n0aheuw/Individual-Project---Mouse-Investigation/final_report.pdf

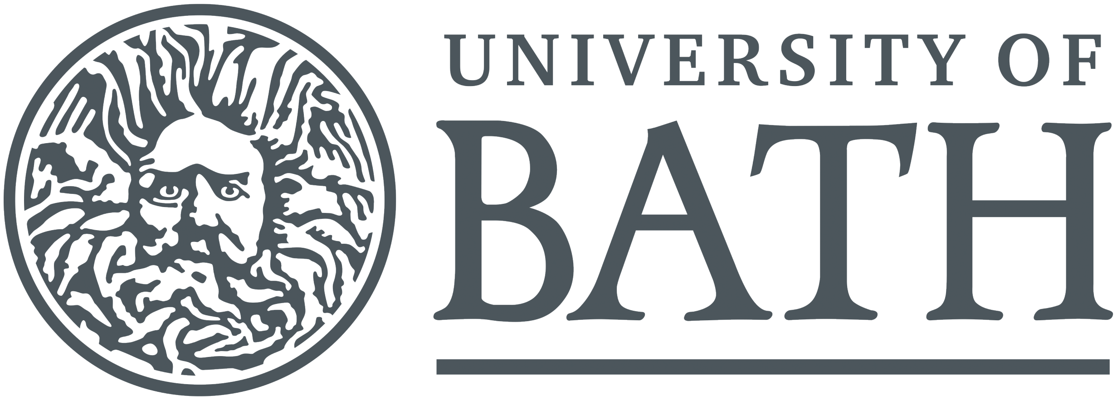
[picture p42: figure]

## Review of Feedback Options for an Accurately Controlled Mouse

## BEng Final Project Report : 2025 (Computer Systems Engineering BEng)

## Noah Johnson

219530358

Wednesday 25th June, 2025

Supervisor: Dr Francis Robinson | Assessor: Dr Stephen Pennock
Main Body Word Count: 8995 | Abstract Word Count: 127

This Project was approved by the Ethics department. Reference: 9890-11232

Abstract

The ‘mouse’ is a second-year group design project. The goal was to investigate ways of improving the ‘mouse’ control loops and reducing its power supply requirements. The aims and objectives were defined as battery reduction, introduction of motor current feedback and wheel speed feedback, accounting for cost, stability and ease of integration. Seven designs were considered; however, only three are recommended as a starting point for future autonomous ‘mouse’ development. The three suggested designs are a simple negative rail generator, low-side current sensing and magnetic speed feedback. All designs were tested and the performance of the three recommended designs was the most satisfactory in terms of accuracy and stability. In addition, the three designs will have a minimal effect on ‘mouse’ cost and are simple to integrate.

## Contents

1 Introduction and Context | 2
2 Position Feedback | 5
3 Speed Feedback | 20
4 Current Feedback | 30

5 Overall Discussion and Conclusions | 42
6 Project Review | 42
7 Acknowledgment | 42
Bibliography | 44
A Appendices | 47

## Figures

1.1 Mouse Track Geometry | | 2
1.2 Mouse Build | | 2
1.3 Original ‘mouse’ System Diagram | | 3
1.4 Updated ‘mouse’ System Block Diagram | | 4
2.1 Simple Voltage Divider | | 5
2.2 Astable 555 Timer Circuit | | 6
2.3 Negative Charge Pump Circuit | | 7
2.4 Precision Diode Clamper Circuit | | 8
2.5 Design A: Schematic | | 9
2.6 Design B: Schematic | 11
2.7 Design A: Oscilloscope Output with input signal of 100mVpp | 13
2.8 Design A: Input Range Response | 14
2.9 Design B: Oscilloscope Output with input signal of 100mVpp | 16
2.10 Design B: Input Range Response | 17
3.1 Hall-Effect Sensor with Pull-up Resitor Schematic | 20
3.2 Diagram of IR emitter and receiver behaviour | 21
3.3 Photographs of ‘mouse’ wheel | 21
3.4 Design D: Schematic | 22
3.5 Design E: Schematic | 24
3.6 Design D: Oscilliscope Rise and Fall | 26
3.7 Design E: Oscilliscope Rise and Fall | 28
4.1 Shunt Resistor Circuit with a motor as circuit load | 30
4.2 Low-side N-channel MOSFET Motor Drive Circuit | 31
4.3 High-side N-channel MOSFET Motor Drive Circuit | 32
4.4 Design F: Schematic | 33
4.5 Design G: Schematic | 35
A.1 RH-32 Breadboard | 51
A.2 34450A KeySight Multi-meter | 52
A.3 DSO1014A Oscilloscope | 52
A.4 AFG2021 Signal Generator | 53
A.5 Lab KeySight E3631A DC Power supply | 53
A.6 AT-6 Tachometer | 54
A.7 Hall-Effect Sensor Distance at Different Angles | 55
A.8 Optical Sensor Distance at Different Angles | 55
A.9 Motor Back EMF Oscilloscope | 57

## Tables

1.1 Sub-Project Letter Assignments | 4
2.1 Design A: Supply and Ground Measurements | 12
2.2 Alphabetically Ordered Estimated Component Costs for Design A | 15
2.3 Design B: Supply and Ground Measurements | 15
2.4 Alphabetically Ordered Estimated Component Costs for Design B | 18
3.1 Design D: RPM Measurements | 25
3.2 Alphabetically Ordered Estimated Component Costs for Design D | 25
3.3 Design E: RPM Measurements | 27
3.4 Alphabetically Ordered Estimated Component Costs for Design E | 27
4.1 Design F: Current Measurements | 37
4.2 Design F: Current Measurements | 37
4.3 Design F: Voltage Measurements 1 kΩ Resistor Load | 38
4.4 Alphabetically Ordered Estimated Component Costs for Design F | 38
4.5 Design G: Current Measurements | 39
4.6 Design G: Current Measurements | 39
4.7 Design G: Voltage Measurements 1 kΩ Resistor Load | 40
4.8 Alphabetically Ordered Estimated Component Costs for Design G | 40
A.1 Total Project Costs | 47
A.2 Estimated Cost of Position Feedback Sub-System | 48
A.3 Estimated Cost of Motor Drive Sub-System | 48
A.4 Hall-Effect Sensor and Tachometer RPM Readings | 57
A.5 Hall-Effect Sensor Working Distance | 57
A.6 Optical Sensor and Tachometer RPM Readings | 57
A.7 Optical Sensor Sensor Working Distance | 57
A.8 Low Side Current and Voltage Measurements | 59
A.9 Low Side Current Measurements with pressure | 59
A.10 Low Side Voltage Measurements with 1 kΩ resistor | 59
A.11 High Side Current and Voltage Measurements | 59
A.12 High Side Current Measurements with pressure | 59
A.13 High Side Voltage Measurements with 1 kΩ resistor | 59

## Acronyms

AC Alternating Current.

ADC Analogue to Digitial Converter.

BJT Bipolar Junction Transistor.

DC Direct Current.

EMF Electro Magnetic Force or Electro Motive Force (Voltage), depending on context.

EMI Electro Magnetic Interference.

GND Ground.

IR Infra Red.

LSB Least Significant Bit.

MOSFET Metal Oxide Semiconductor Field Effect Transistor.

PWM Pulse Width Modulation.

RPM Revolutions Per Minute.

## Definitions

Magnetic Field, H in units of Amps per metre (A/m).

Magnetic Flux, B in units of Tesla (B = µ0).

Permiabilty of a vacuum, µ0 = 4 ∗ π ∗ 10⁻⁷
(H/m).

1

## Introduction and Context

## 1.1 Overview

The autonomous ‘mouse’ is a design project conducted by second-year students at the University of Bath to develop their understanding of control systems and analogue circuit design. The overarching aim of the design project is to complete a lap around a 20 m track (Fig.1.1) in the fastest time possible [1]. The ‘mouse’ project uses differential drive achieved through two motors to navigate around, as seen in Fig.1.2.

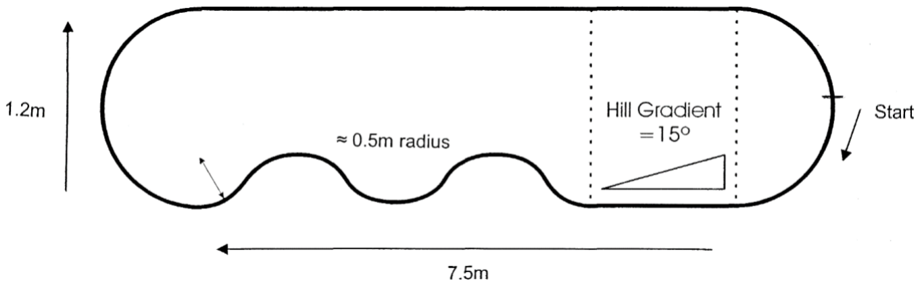
[picture p43: figure]

Figure 1.1: ‘mouse’ test track geometry taken from [1]


Figure 1.2: ‘mouse’ build example taken from [1]

2

The initial concepts used to design the ‘mouse’ in the second year are described in Dr Robinson’s initial document outlining the project [1]. A list of basic ‘mouse’ building blocks can be seen below, and their integration with one another in Fig.1.3.

- LC filter circuit tuned to 20 kHz.
- Signal amplifier circuit.
- Peak detector.
- Arduino microcontroller, takes the input signal and conducts PID control to produce an output drive signal for the motors.
- Motor drive circuit, utilising transistors acting as switches to allow the low-power Arduino to drive the high-power motor load.

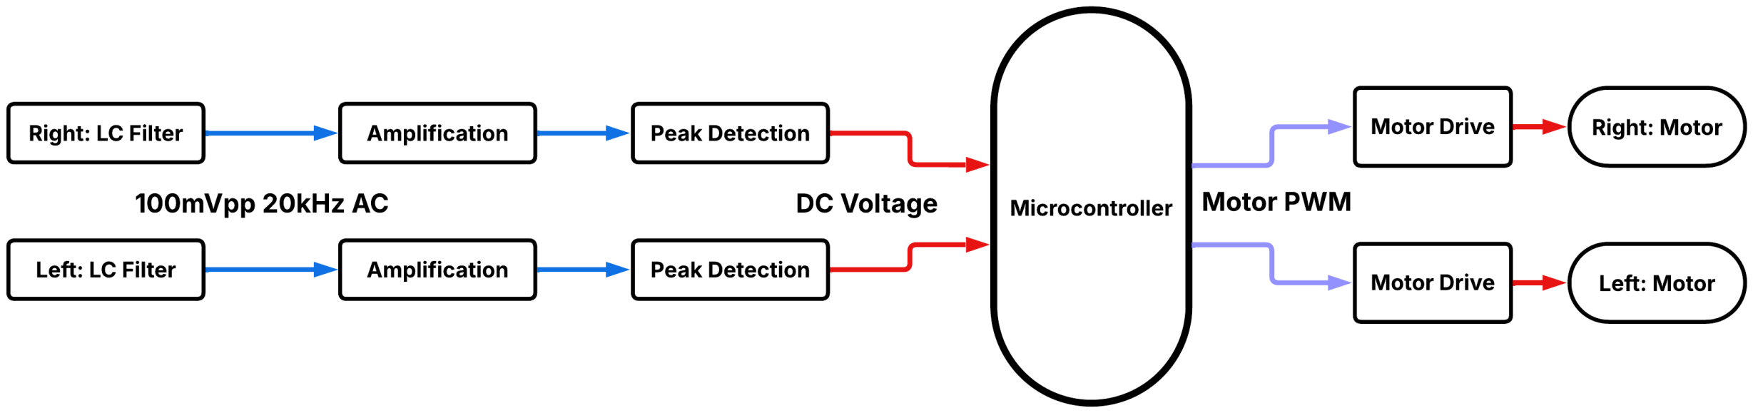
[picture p44: figure]

Figure 1.3: Original ‘mouse’ system diagram: Blue, AC Signals; Red, DC Voltages; Purple, Digital Control Signals

### 1.1.1 Aims and Objectives

As previously outlined in [2], the project has three main aims with varying objectives associated with them:

1. Introduce additional stable and accurate feedback loops to the ‘mouse’ control loop, focusing on the lack of feedback from the motors.
- Motor current.
- Motor speed.
2. Design alterations and suggestions for the ‘mouse’ that are low-cost and straightforward to integrate.
- Designs should be simple to integrate into a ‘mouse’ project and documentation be available in textbooks or data sheets to assist students if the design is harder to implement.
- Component choice to be limited to low-cost components/modules, keeping a low-cost per ‘mouse’. Sub-system changes will ideally keep the cost within +25% of the original cost.
3. Investigate the power supply options for the mouse, identifying methods for reducing power supply requirements.
- The number of battery packs used to power the mouse ideally reduced from 2 x 9 V PP3 alkaline batteries and 4 x 1.2 V NiMH AA batteries.

3

### 1.1.2 Constraints

The constraints of this project follow those set out in [1], with an additional self-imposed constraint of not increasing the sub-system cost by over 25% when compared to current sub-systems.

## 1.2 Initial Ideas Regarding Implementation

- To reduce consumables, weight, and improve environmental impact by removing one of the 9 V alkaline batteries.
- To improve the motor control loop by adding motor current and wheel speed as additional feedback parameters. Potential new system diagram as shown in Fig.1.4.

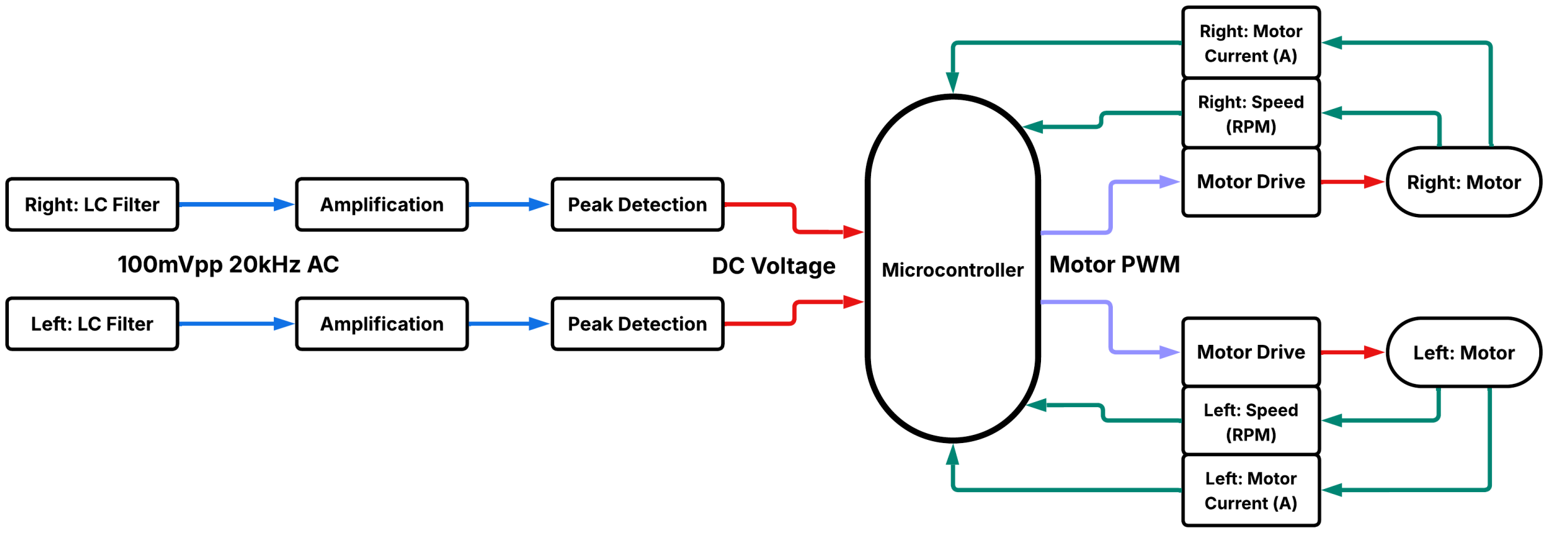
[picture p45: figure]

Figure 1.4: Updated ‘mouse’ system diagram: Blue, AC Signals; Red, DC Voltages; Purple, Digital Control Signals; Teal, Additional Feedback

Table 1.1: Sub-Project Letter Assignments

Design Letter | Sub-Project Name | Sub-system
A | Voltage Divider | Position Feeedback
B | 555 Timer | Position Feeedback
C | Precision Diode Clamper | Position Feeedback
D | Hall Effect Sensor | Speed Feeedback
E | IR Optical Sensor | Speed Feeedback
F | Low Side Motor Drive | Current Feedback
G | High Side Motor Drive | Current Feedback

Table 1.1 lists the sub-projects and the letters assigned for quick reference, including the relevant affected sub-systems.

### 1.2.1 Results Gathering

All testing procedures and methods list the equipment used, photographed in Appendix A.4.

4

## Position Feedback

## 2.1 Overview

This section discusses the position feedback sub-system of the autonomous ‘mouse’. The position feedback within the ‘mouse’ control loop is responsible for detecting the mouse’s approximate location in relation to the track wire and providing a position feedback signal for steering correction. The current circuit design utilises inductive pick-up coils to sense the AC magnetic flux generated by a trackwire conducting at 20 kHz ≃ 1 A. The induced voltage signal is subsequently processed by filtering, amplification and peak detector stages to produce a DC feedback signal [1].
A key focus of this section is to address one of the limitations identified in the original sensing sub-system design: the requirement for a dual power supply to bias the operational amplifier appropriately to process a 100 mVpp AC signal. This dependency increases the number of batteries required, increasing the ‘mouse’ weight and the project’s environmental impact by increasing e-waste. This section aims to explore and implement alternative circuit configurations capable of operating from a single supply of 9 V DC. The proposed solutions must maintain signal integrity and compatibility with downstream control systems. The designs must be evaluated on performance, simplicity, and cost of implementation.

## 2.2 Design Concepts and Methods

### 2.2.1 Design A: Voltage Divider

Design A (Fig.2.1) employs a voltage divider to proportionally split the 9 V input supply voltage to create a new virtual GND. The division is done across two or more resistive sources (see Fig.2.1) with the output voltage dependent on the ratio between the component’s impedances. The resulting output voltage equation (Eq.2.1) is derived using Kirchhoff’s Voltage Law and Ohm’s Law, where Z1 and Z2 are impedances of the two components shown in Fig.2.1. The impedance ratio in Design A is set at 1 : 1 resulting in a 4.5 V virtual GND

VOut =

Z2
Z1 + Z2
∗ Vs | (2.1)

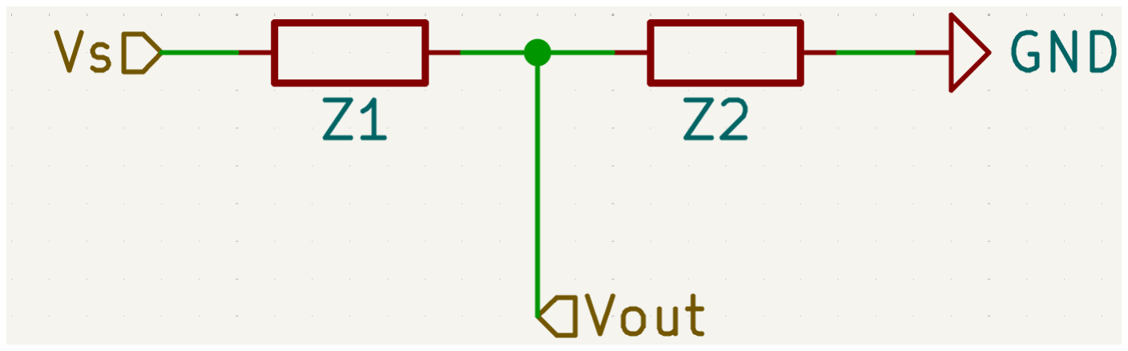
[picture p46: figure]

Figure 2.1: Voltage divider circuit with two resistive components, Vs is the supply voltage and Vout is the reduced voltage reference.

The new 4.5 V virtual GND becomes the new reference point for the operational amplifier and input signal. The operational amplifier and input signal will treat the 4.5 V reference as its

5

GND. Biasing the operational amplifier and input signal this way allows the supply rails to be at 9 V (+ve supply) and 0 V (−ve supply), and allows for the use of a single power supply, however the operational amplifier is now operated with a ±4.5 V supply halving amplification potential. Therefore, an AC-coupled input signal will not reduce the inputs below the −ve supply rail and cause the operational amplifier to malfunction.

### 2.2.2 Design B: 555 Timer with Negative Charge Pump

Design B (Fig.2.2) utilises a 555 timer circuit in an astable configuration to generate a rectangular wave output, which drives a negative charge pump circuit. This arrangement allows the generation of a negative voltage supply from a single positive 9 V voltage source.

Astable 555 Timer Operation

The 555 timer’s oscillation frequency is determined by the values of two resistors (Ra and Rb) and one capacitor (C) as shown in Fig.2.2. The resulting output is a square wave with frequency calculated using Eq.2.2 as defined by Texas Instruments [3, p.12].

f =

1.44
(Ra + 2Rb) ∗ C

(2.2)

The duty cycle of the astable output can be calculated using Eq.2.3 as defined by Texas Instruments [3, p.12].

Duty =

Ra + Rb
Ra + 2Rb
∗ 100% | (2.3)

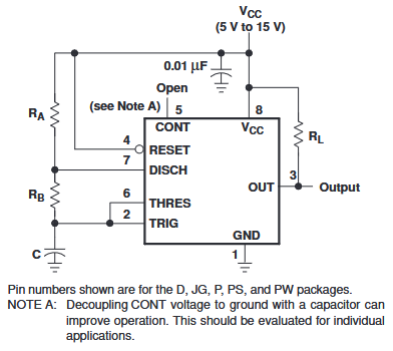
[picture p47: figure]

Figure 2.2: Astable 555 timer circuit configuration showing component connections and pin assignments [3, p.12]. The circuit illustrates the standard configuration for generating rectangular wave outputs with frequency determined by RA, RB, and C values.

6

Negative Charge Pump Circuit

The negative charge pump takes the oscillating output from the 555 timer and converts it to a negative DC voltage through a network of capacitors and diodes (Fig.2.3) as described by Horowitz and Hill [4, pp.638-639].
The circuit operates by alternately charging and discharging capacitors through the diodes following the input waveform transitions. When the input signal (Vs) transitions to a high state, capacitor C1 charges through diode D2 towards GND. Diode D1 remains reverse-biased in this state, preventing current flow towards the output stage. As Vs switches to a low state, the voltage at the left side of C1 falls below GND potential. This voltage shift forward-biases diode D1, allowing charge to transfer to capacitor C2, which stores the accumulated negative voltage. During each subsequent cycle of Vs, the additional charge is transferred to C2, gradually increasing the magnitude of the negative output voltage at Vneg. Diode D2 prevents the backflow of current during the low phase of Vs, ensuring efficient charge transfer in one direction. The steady-state negative voltage developed across C2 depends on the amplitude of Vs, the capacitance values of C1 and C2, the forward voltage drops of D1 and D2, and the switching frequency of the input signal.


Figure 2.3: Schematic of a negative charge pump circuit using a pair of diodes and two capacitors. The circuit generates a negative output voltage (Vneg) from a positive square wave input (Vs) by transferring charge through C1 and rectifying the output via D1 and D2. Capacitor C2 acts as an output reservoir, smoothing the generated negative voltage.

The voltage efficiency of the charge pump under load can be defined as shown in Eq.2.4 where Vneg is the output voltage and V s is the supply voltage.

η =

−(Vneg)
Vs

(2.4)

The negative charge pump creates a virtual negative voltage rail relative to the system GND. This new virtual negative rail and the 9 V power supply are used as the power rails for an operational amplifier. This setup allows the operational amplifier to have a dual supply from a single positive power supply, enabling regular signal processing operation.

7

### 2.2.3 Design C: Precision Diode Clamping

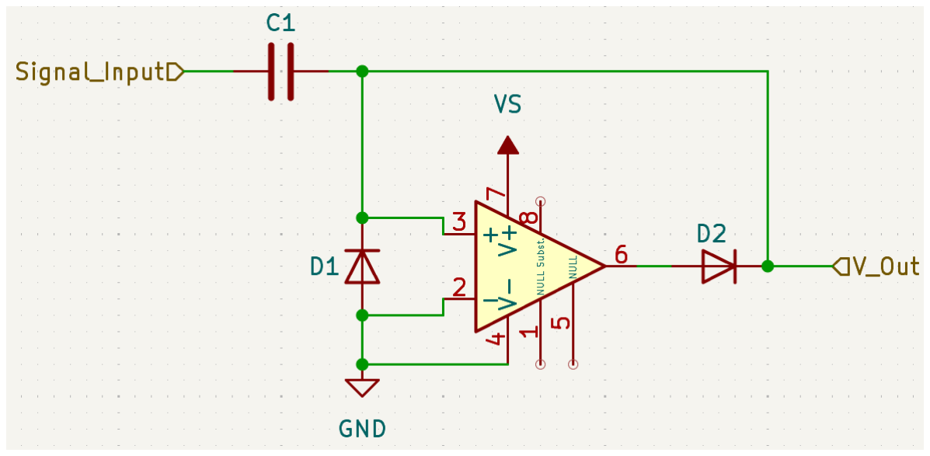
[picture p48: figure]

Figure 2.4: Schematic of a precision diode clamper.

Design C utilised a precision diode clamping circuit (Fig.2.4) to clamp the voltage level of the input signal above 0 V and hence above GND. When the ‘Signal Input’ drops below zero, the diode becomes forward-bias and allows current to pass, causing the capacitor to charge to the voltage level of the negative peak. The diode switches off once the input voltage rises back into the positive range, preventing further current flow. The charged capacitor then effectively adds its stored voltage to the input signal, shifting the entire waveform upward. As a result, the negative portions of the signal are raised closer to zero volts or higher. By pulling the signal above 0 V the signal can be amplified by an operational amplifier with supply rails at 9 V (+ve supply) and 0 V (−ve supply) allowing for the use of a single power supply. The effectiveness of this method depends on the characteristics of the operational amplifier used.

8

## 2.3 Procedures

### 2.3.1 Design A: Voltage Divider

Assembly

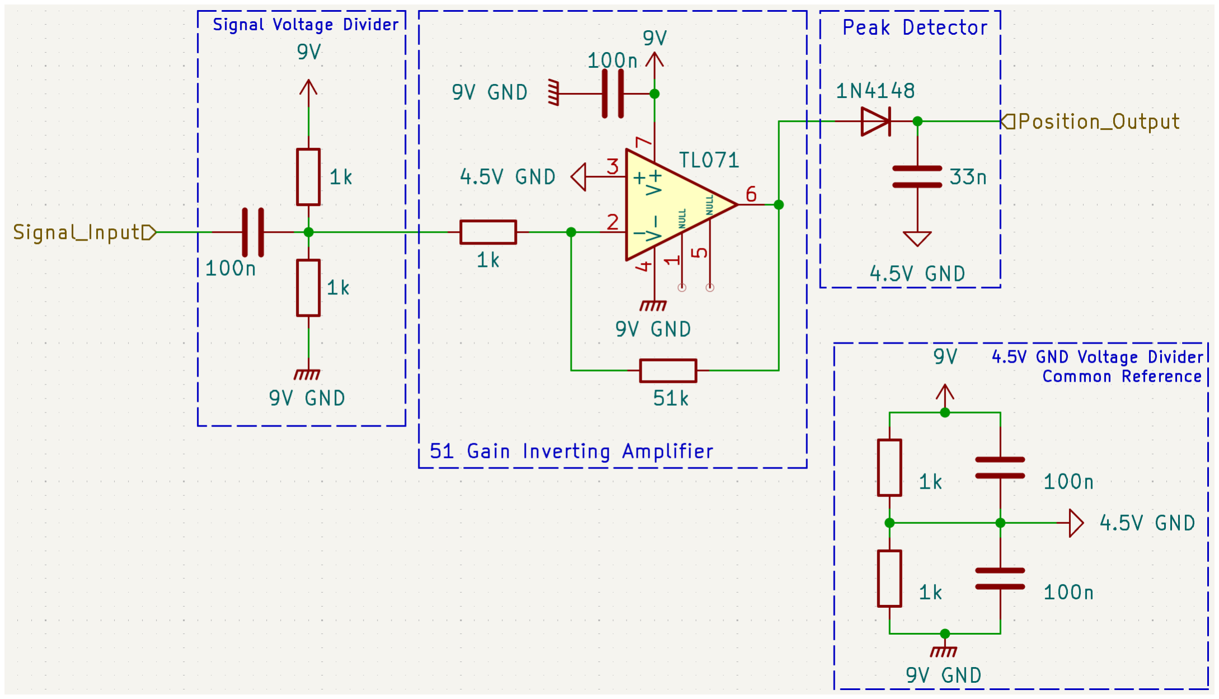
[picture p49: figure]

Figure 2.5: Schematic of Design A. Including a voltage divider signal conditioning circuit with a 4.5 V virtual GND, ×51 inverting amplifier, and peak detector, powered from a single 9 V DC supply.

Design A was built on a standard RH-32 breadboard following the design outline in Fig.2.5. Firstly, the TL071 [5] operational amplifier was inserted into the breadboard and was configured in an inverting arrangement with a gain factor (Av) of -51 (Eq.2.5), the gain was set by the 51 kΩ feedback resistor (Rf ) and 1 kΩ input resistor (Rin).

Av = −

Rf

Rin

(2.5)

All connections made to the inverting input (pin 2) were as short as possible to reduce parasitic capacitance as suggested by Texas Instruments [5, p.36]. The 9 V DC E3631A lab power supply was connected to pin 7 (+ve supply rail) with a 100 nF decoupling capacitor. The 9 V GND was then connected to pin 4 (−ve supply rail).
Secondly, a voltage divider circuit was constructed to create the 4.5 V GND (virtual GND). As shown in Fig.2.5 two 1 kΩ resistors were connected in parallel with two 100 nF capacitors, the input of the voltage divider was connected to the 9 V DC E3631A lab power supply and the 9 V GND was connected to the bottom. The output 4.5 V virtual GND was then taken from the central connection as seen in Fig.2.5. The new 4.5 V virtual GND was then connected to the non-inverting input of the TL071.
Third, a voltage divider circuit was constructed to bias the input signal. As shown in Fig.2.5 two 1 kΩ resistors were connected in series connecting the 9 V DC E3631A lab power supply

9

and the 9 V GND. The ‘Signal Input’ was then coupled with a 100 nF capacitor at the centre point of the resistor and then further connected to the 1 kΩ resistor (Rin).
Finally, a simple peak detector was assembled after the TL071 using a 1N4148 [6] and 33 nF capacitor. The peak detector was constructed as shown in Fig.2.5 with the output of the TL071 connecting to the anode of the diode and the GND connection of the capacitor being connected to the 4.5 V virtual GND.

Testing

The steps for Testing Design A are as follows:

1. 9 V, 4.5 V virtual GND and 9 V GND were verified using a KeySight 34450A multimeter.
2. The Position Output DC voltage was measured three times using a KeySight 34450A multimeter when no input signal was applied to check for a potential failure mode, the values were then averaged.
3. The AFG2021 signal generator was turned on, set to high impedance and connected to ‘Signal Input’ with GND connected the 4.5 V virtual GND. Additionally, a filtering capacitor of 100 nF was connected between the Signal Input and GND to reduce noise, which wouldn’t be included in the final design as the signal normally comes from an LC filtered source. The output signal parameters were a Sine Wave set to 20 kHz frequency and 100 mVpp amplitude.
4. The KeySight DSO1014A oscilloscope was connected to Design A, making sure the oscilloscope probe ratio matched the input signal ratio and probe points were as close as possible to the measurement point:
- Channel 1: Output of AFG2021 Signal Generator
- Channel 2: TL071 pin 6 with probe reference connected to 4.5 V Common Reference
- Channel 3: ‘Position Output’ with probe reference connected to 4.5 V Common Reference
5. The steady-state 100 mV waveform was observed and stored on an external USB as a CSV for later analysis in Excel.
6. The oscilloscope probes were then removed, and the KeySight 34450A multimeter was connected. The positive probe connected to ‘Position Output’ and the reference probe to Design A’s Common Reference.
7. The steady-state DC voltage at 100 mVpp was recorded three times. The amplitude of the input signal was reduced by 10 mVpp and the new steady-state voltage was recorded in Microsoft Excel. This reduction of 10 mVpp was repeated till the amplitude reached 20 mVpp.

All measurements were taken after a 5-second stabilisation period to minimise transient effects and were conducted at room temperature (approximately 22°C). The oscilloscope output was imported into Excel and used to generate graphs for analysis. The multimeter readings were tabulated and analysed; linear regression was performed to evaluate the system’s gain and linearity.

10

### 2.3.2 Design B: 555 Timer and Negative Charge Pump

Assembly

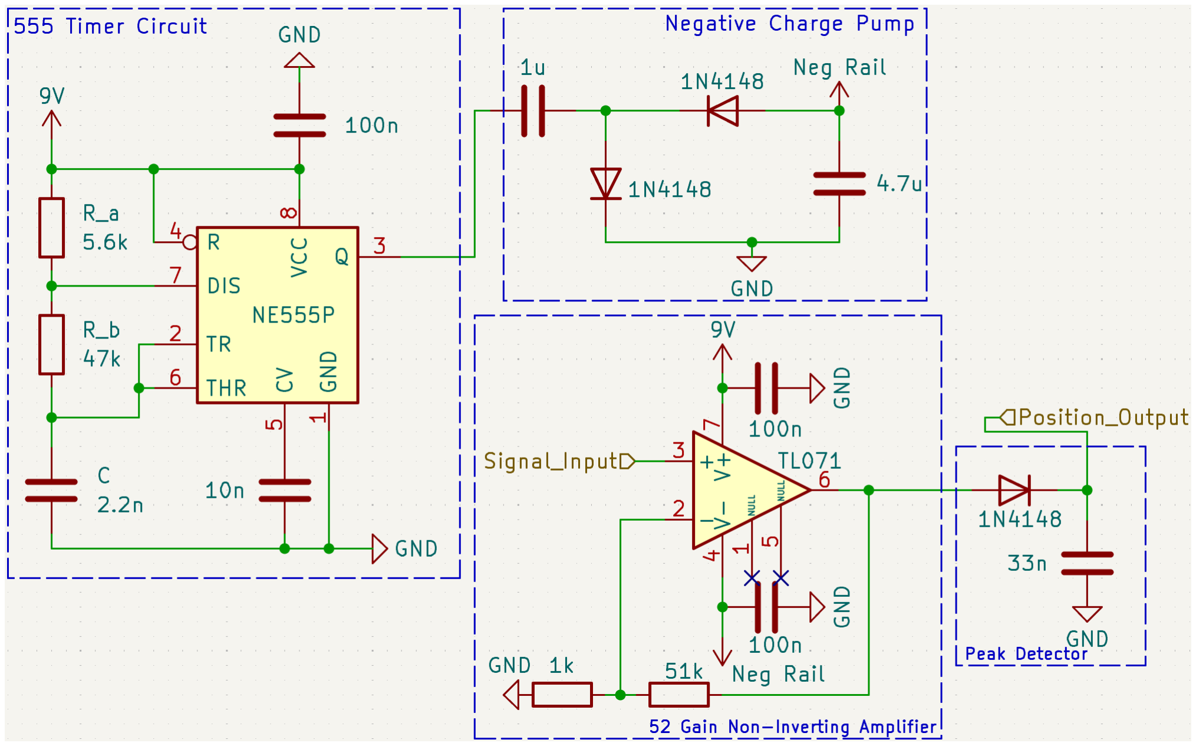
[picture p50: figure]

Figure 2.6: Schematic of Design B. Including a 555 astable timer with negative charge pump powered and x52 Non-inverting amplifier, powered from a single 9V DC supply.

Design B was built on a standard RH-32 breadboard following the design outline in Fig.2.6. Firstly, the astable mode 555 timer circuit was built using a NE555P [3], the timing components being a 5.6 kΩ (Ra), 47 kΩ (Rb) and 1 nF (C) as shown in Fig.2.6 following the naming convention used by Texas Instruments [3, p.12]. The timing components selected create an oscillation frequency of 14.46 kHz. In addition, a 10 nF decoupling capacitor was placed between pin 5 (Control) and GND to improve stability as seen in Fig.2.6 and suggested by Texas Instruments [3, p.12]. Furthermore, during assembly, the timing capacitor and decoupling capacitors were placed as close as possible to the LM555 as advised to reduce possible parasitic capacitance. The 9 V DC E3631A lab power supply was connected to pins 4, 8 and the top of Ra; the 9 V supply additionally had a 100 nF decoupling capacitor. After the 555 timer construction the accompanying negative charge pump circuit was built as seen in Fig.2.6 using two 1N4148 diodes and two capacitors of values 1 µF and 4.6 µF.
Following on the TL071 operational amplifier [5] was inserted into the breadboard and was configured in a non-inverting arrangement with a gain factor (Av) of gain factor of 52 (Eq.2.6) the gain was set by the 51 kΩ feedback resistor(Rf ) and 1 kΩ GND resistor (RGND).

Av = 1 +

Rf

RGND

(2.6)

Again, all connections made to the inverting input (pin 2) were as short as possible, as mentioned in Section 2.3.1. The 9 V DC E3631A lab power supply was connected to pin 7 (+ve

11 supply rail) and the negative charge pump output was connected to pin 4 (−ve supply rail); both supply rails had 100 nF decoupling capacitors.

Testing

Firstly, the DC 9 V, negative charge pump supply rail and 9 V GND were verified using a KeySight 34450A multimeter. The testing method for Design B followed the same procedure as outlined in Section 2.3.1 steps 2 → 7. All measurements were taken under the same conditions and analysed accordingly as defined in 2.3.1.

### 2.3.3 Design C: Precision Diode Clamping

Design C was considered but ultimately not physically tested as the low input voltage range [0,100 mV] could not properly forward bias the input diode and risked pulling the inverting input of the operational amplifier below the available negative rail (0 V). This would have resulted in the TL071 operational amplifier operating outside its recommended input range, potentially compromising circuit performance and reliability.

## 2.4 Results

### 2.4.1 Design A: Voltage Divider

Table 2.1: Measured DC 9 V supply rail and 4.5 V virtual GND relative to circuit GND. The potential difference between the circuit GND and the power supply GND was also recorded.

Measurment Point | Measured 3s.f.(V)
9 V Supply Rail | 8.99
4.5 V Virtual GND | 4.49
GND | 6.68 ∗ 10⁻⁴

The voltage divider was verified at three key points: 9V Supply Rail, 4.5V Virtual GND and GND, as shown in Table 2.1:

- DC 9 V input: The output voltage was measured at 8.99 V, showing a negligible deviation from the expected value.
- 4.5 V Virtual GND: The measured voltage was 4.49 V, displaying a minimal difference from the theoretical result.
- 0 V (GND): The measured voltage was measured at 6.68 ∗ 10⁻⁴ V , approximating to zero confirming correct operation near GND.

As summarised in Table 2.1, these results indicate that the voltage divider functioned as expected. When Design A was tested at a 0Vpp input signal the ‘Position Output’ remained stable at 40 mV.

12


Figure 2.7: Graph showing Design A behaviour at 100 mVpp. The traces are the Signal Generator output (Channel 1: Blue), TL071 Operational Amplifier output (Channel 2: Red), and ‘Position Output’ (Channel 3: Green) plotted against time (mS). The Signal Generator output is plotted on the right Y-axis in millivolts (mV), while the operational amplifier and Position Output are plotted on the left Y-axis in volts (V).

The DSO1014A oscilloscope captured three signals: the ‘Signal Input’ (Channel 1), the output of the TL071 operational amplifier (Channel 2), and the ‘Position Output’ (Channel 3), as shown in Fig.2.7.

- ‘Signal Input’: The input sinusoidal waveform with a frequency of 20 kHz had peak values ranging from −48.8 mV to 45 mV hence a 96 mVpp signal. This indicates a discrepancy in the signal generator output signal and the observed peak-to-peak value.
- TL071 Output: The observed output signal inverts the input signal and exhibited peak values of approximately -1.8 V and 2 V, indicating a lower-than-expected gain of ≈ −42.
- ‘Position Output’: The output of the peak detector shows a steady DC value of approximately 1.7 V. This value is slightly lower than the peak value of the amplified signal (approximately 2 V), due to the voltage drop across the peak detector diode.

Overall, the oscilloscope graph in Fig.2.7 confirms that the operational amplifier is amplifying the input signal, though at a lower gain than intended. The peak detector captures a value slightly lower than the peak voltage but still approximately tracks the signal’s maximum value.

13


Figure 2.8: Graph of Design A Input Signal Peak Voltage (V) against observed ‘Position Output’ (V). Average observed output voltage is represented in Blue, and predicted output voltage is represented in Red.

Fig.2.8 demonstrates the relationship between the input peak voltage and the observed output voltage within Design A. As shown in Fig.2.8, the output voltage increases proportionally with the input peak voltage, following a near-linear trend as expected for a fixed-gain inverting amplifier circuit. However, the observed output values were consistently lower than the theoretical values predicted by the amplifier’s nominal gain setting of 51, indicating a reduction in observed gain within the circuit.
The maximum observed voltage was 1.721 V and a minimum observed voltage of 0.280 V. It should also be noted that the linear trend does not cross through the origin but crosses the x-axis at ≈ 0.002 V.
These observations confirm the amplifier’s overall linear behaviour and highlight the practical limitations demonstrated by the difference between the theoretical gain and the observed gain.

14

Cost of Implementation

Table 2.2: Alphabetically Ordered Estimated Component Costs for Design A

Component | Quantity | Unit Price (£) | Total Price (£)
100nF Ceramic Disc Capacitor (50V) [7] | 4 | 0.17 | 0.68
1kΩ Resistor [8] | 5 | 0.162 | 0.81
1N4148 Signal Diode [9] | 1 | 0.01 | 0.01
33nF Capacitor (Polyester, 100V) [10] | 1 | 0.122 | 0.122
51kΩ Resistor [11] | 1 | 0.054 | 0.054
9V Battery (RS PRO Alkaline) [12] | 1 | 2.08 | 2.08
TL071 Op-Amp (Single BiFET) [13] | 1 | 0.45 | 0.45
Total Estimated Cost | | | £4.21

Table 2.2 details the individual components required to implement Design A, alongside their quantities, specifications and unit costs based on UK-sourced pricing at the time of writing. The cost of implementation within the ‘mouse’ would be £5.68, adding an additional inverting amplifier, peak detector and signal voltage divider. The cost difference between the original sub-system (Appendix A.2) is -£1.70 a reduction of 23%.

### 2.4.2 Design B: 555 Timer and Negative Charge Pump

Table 2.3: Measured 9V supply rail and charge pump negative supply rail relative to the circuit GND. The potential difference between circuit GND and E3631A lab power supply GND was also recorded to verify correct internal biasing and GND reference stability within the single-supply configuration.

Measurement Point | Measured 3s.f.(V)
9 V Supply Rail | 8.99
Negative Rail | -5.50
GND | 8.22 ∗ 10⁻⁴

The 555 timer design was verified at three key points: 9 V Supply Rail, Negative Supply Rail, and GND, as shown in Table 2.3:

- 9 V input: The output voltage was measured at 8.99 V, showing a negligible deviation from the expected value.
- Negative Rail: The measured voltage was −5.50 V, displaying an efficiency of

−5.50
9 ≈ 61.1%. Measured under circuit load.
- 0 V (GND): The measured voltage was measured at 8.22 ∗ 10⁻⁴ V, approximating to zero confirming correct operation near GND.

As summarised in Table 2.3, these results indicate that the 555 timer design functioned as expected. In addition, when Design B was tested at a 0Vpp input signal the ‘Position Output’ remained stable at 40 mV.

15


Figure 2.9: Graph showing Design B behaviour at 100 mVpp. The traces are Signal Generator output (Channel 1: Blue), TL071 Operational Amplifier output (Channel 2: Red), and ‘Position Output’ (Channel 3: Green) plotted against time (mS). The Signal Generator output is plotted on the right Y-axis in millivolts (mV), while the operational amplifier and Position Output are plotted on the left Y-axis in volts (V ).

The DSO1014A oscilloscope captured three signals: the ‘Signal Input’ (Channel 1), the output of the TL071 operational amplifier (Channel 2), and the ‘Position Output’ (Channel 3), as shown in Fig.2.9.

- ‘Signal Input’: The input sinusoidal waveform with a frequency of 20 kHz had peak values ranging from −45.6 mV to 42.4 mV, 88 mVpp signal.
- TL071 Output: The observed output signal follows the input signal and exhibited peak values of approximately -2.2 V and 2 V, indicating a lower-than-expected gain of ≈ 45.
- ‘Position Output’: The output of the peak detector shows a steady value of approximately 1.6 V. This value is lower than the peak value of the amplified signal (approximately 2 V), due to the voltage drop across the peak detector diode.

Overall, the oscilloscope graph in Fig.2.9 confirms that the operational amplifier is amplifying the input signal at a lower gain than intended. The peak detector captures a value lower than the peak voltage but still approximately tracks the signal’s maximum value.

16


Figure 2.10: Graph of Design B Input Signal Peak Voltage (V) against observed ‘Position Output’ (V). Average observed output voltage is represented in Blue, and predicted output voltage is represented in Red.

Fig.2.10 demonstrates the relationship between the input peak voltage and the observed output voltage within Design B. As shown in Fig.2.10, the output voltage increases proportionally with the input peak voltage, following a near-linear trend as expected for a fixed-gain non-inverting amplifier circuit. However, observed output values were consistently lower than the theoretical values predicted by the amplifier’s nominal gain setting of 52, indicating a reduction in observed gain within the circuit.
The maximum observed voltage was 1.601 V and a minimum observed voltage of 0.160 V. It should be noted that the linear trend does not cross through the origin but crosses the x-axis at ≈ 0.006 V.
These observations confirm the amplifier’s overall linear behaviour, highlighting the practical limitations demonstrated by the difference between the theoretical gain and observed gain.

17

Cost of Implementation

Table 2.4: Alphabetically Ordered Estimated Component Costs for Design B

Component | Quantity | Unit Price (£) | Total Price (£)
100nF Ceramic Disc Capacitor[7] | 3 | 0.17 | 0.51
1kΩ Resistor [8] | 1 | 0.162 | 0.162
1µF Electrolytic Capacitor [14] | 1 | 0.218 | 0.218
1N4148 Diode [9] | 1 | 0.01 | 0.01
2.2nF Ceramic Capacitor [15] | 1 | 0.068 | 0.068
33nF Polyester Capacitor [10] | 1 | 0.12 | 0.12
4.7µF Electrolytic Capacitor [16] | 1 | 0.206 | 0.206
47kΩ Resistor [17] | 1 | 0.167 | 0.167
51kΩ Resistor [11] | 1 | £0.054 | £0.054
5.6kΩ Resistor [18] | 1 | 0.106 | 0.106
9V Battery (RS PRO Alkaline) [12] | 1 | 2.08 | 2.08
10nF Polyester Capacitor [19] | 1 | 0.112 | 0.112
NE555P Timer IC [20] | 1 | 0.152 | 0.152
TL071 Operational Amplifier [13] | 1 | 0.45 | 0.45
Total Estimated Cost | | | £4.41

Table 2.4 details the individual components required for the implementation of Design B, alongside their quantities, specifications, suppliers, and unit costs based on UK-sourced pricing at the time of writing. The cost of implementation within the ‘mouse’ would be £5.54, adding an additional non-inverting amplifier and peak detector. The cost difference between the original sub-system (Appendix A.2) is -£1.84 a reduction of 25%.

## 2.5 Discussion

This section covered the evaluation of three design solutions proposed to facilitate the operation of the position feedback system from a single DC supply of 9 V. Firstly, of the three designs assessed, two designs produced stable outputs when assembled, suggesting these are possible solutions to the dual power supply issue. Secondly, the output signals produced by the physical designs were of an observable voltage level that a microcontroller could utilise for position feedback. Thirdly, the cost of implementation is less than that of the current dual power supply operational amplifier circuit.
Before further interpreting the findings, we must note several important limitations. Firstly, the current methods do not account for varying temperatures. All tests were carried out at room temperature 22 ◦C. Changes in electrical characteristics could cause incorrect design behaviour due to an increase or decrease in device temperatures. This limitation should be considered when shrinking the circuit size down and concentrating components together, increasing potential heat interference from hot components, especially the MOSFETs (IRLZ44N). Secondly, no accommodation is made regarding the observed input signal amplitude and signal generator amplitude discrepancy. This could introduce uncertainty into the observed output DC voltages and the corresponding gain achieved. The primary project aim was to evaluate the linearity and efficacy between designs, rather than obtain absolute voltage values with high precision. Thirdly, for consistency of results the 9 V power rail in Design A and B was provided with a

18 laboratory power supply and not batteries, which will have a higher impedance especially as they discharge with use potentially impacting performance.

Design Performance

Design A and B provided consistent and reliable output voltages that linearly followed the input signal voltage. However, the observed ‘Position Output’ voltage was lower than the amplifier output due to the voltage drop across the diode; this could be corrected by placing the diode inside the feedback loop. In addition, this would also remove any diode drop with temperature. Furthermore, the observed gain in both designs was lower than expected; however, this shouldn’t be an issue in actual application, as variable resistors are used to match the signals, and additional Arduino scaling can be done to balance the left and right sensor signals.

Complexity

Design A is simple in background knowledge and requires only basic electrical engineering principles to integrate. In contrast, Design B has more complexity due to introducing difficult principles and complicated circuitry; however, documentation is available to guide the creation of Design B.

Cost

Both Design A and B provide a cost reduction from the original sub-system due to the expensive nature of batteries and the removal of one. Comparing the two designs to one another, Design B is slightly more cost-effective with a larger total cost reduction.

Further Investigations

Further evaluation should be conducted on Design A and B once integrated into a working ‘mouse’, validating circuit performance with battery supplies and interaction with LC filter circuit. In addition, a set of secondary sensors on the rear of the ‘mouse’ should be investigated, with the intention of using them to help identify straights and corners more effectively.

Recommendations

On the whole, both Design A and B are recommended as potential solutions to solve the dual power supply operational amplifier issue. Both designs have valid use cases and should be considered, however in the current state of the ‘mouse’ project Design B is the final recommendation, costing less and having a greater operational range than Design A.

19

## Speed Feedback

## 3.1 Overview

The primary consideration of this section is developing and evaluating a speed feedback sub-system for the autonomous ‘mouse’. A limitation of the current ‘mouse’ design is its inability to monitor the RPM of the wheels, meaning the controller cannot adjust the PWM accounting for a sudden reduction or increase in RPM. A typical example of a RPM-related issue is the descent of the track hill. When descending, it is common for the ‘mouse’ to lose control due to a sudden increase in RPM and the controller’s inability to account for this. The proposed solutions must provide reliable and responsive RPM readings. The solutions will be evaluated based on the following criteria: stability, simplicity of integration and cost of implementation.

## 3.2 Design Concepts and Methods

### 3.2.1 Design D: Hall-Effect Sensor

Design D (Fig.3.1) utilises a digital hall-effect sensor to detect the presence of a magnet attached to the ‘mouse’ wheel, outputting a signal based on the presence or absence of a magnetic field. Many hall-effect sensors have an open-drain or open-collector output stage, meaning they can pull the output low but not drive it high, for example Allegro A3213 [21].

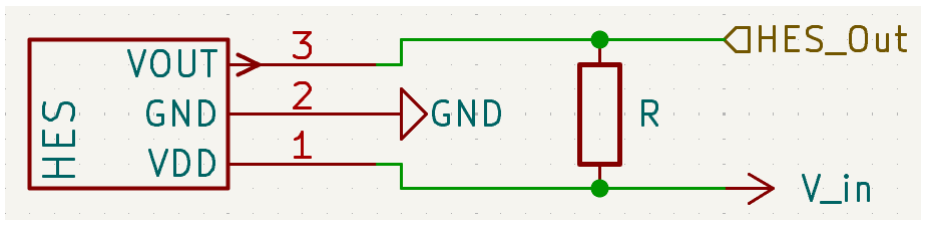
[picture p51: figure]

Figure 3.1: Schematic of a hall-effect sensor circuit with pull-up resistor

To obtain an observable pulse it is common to use a pull-up resistor between the supply rail and sensor output (Fig.3.1). This circuit setup results in logic low (0: negative pulse) observed on VOUT when applying a magnetic field and logic high (1: high voltage) when not applying a magnetic field. Typical values for the pull-up resistor (‘R’) range from 1 kΩ → 50 kΩ depending on required logic levels, speed and current. A smaller ‘R’ value results in a faster response time and an increased current draw when the output is low. A pull-up resistor is critical when interfacing the hall-effect sensor with digital inputs on microcontrollers or logic devices. Without a pull-up resistor, the output may float, resulting in undefined or noisy readings.

20

### 3.2.2 Design E: IR Optical Sensor

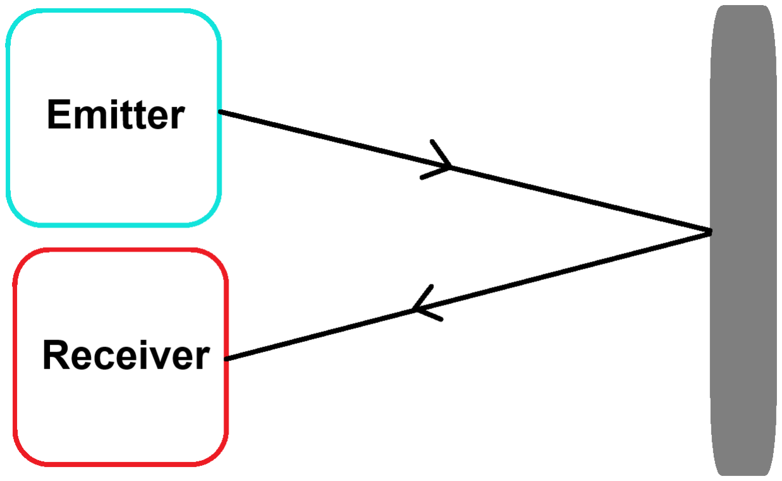
[picture p52: figure]

Figure 3.2: Diagram of IR emitter and receiver behaviour

Design E employs a digital IR emitter and receiver module [22] for detecting the presence of tachometer tape on the ‘mouse’ wheel, outputting a signal based on the presence or absence of IR reflection. The system typically consists of an IR Light Emitting Diode (LED) as the emitter and a phototransistor or photodiode as the receiver. The IR LED emits invisible infrared light toward a target area.
The module utilises a reflective configuration; the emitter and receiver are positioned adjacent facing the target area. When the tachometer tape enters the sensor’s detection zone, it reflects the IR light towards the receiver (Fig.3.2). The sensor output is then converted from analogue to digital via a comparator or signal conditioning, and the output remains logic low (0: low voltage) when no reflection is detected and switches to logic high (1: high pulse) when a reflection is detected.

## 3.3 Procedures

Initially, the ‘mouse’ wheel was modified, a 3 mm neodymium magnet [23] was adhered using hot glue to the outside of the wheel and covered by reflective tachometer tape [24] as shown in Fig.3.3.


(a) (b)

Figure 3.3: Photographs of ‘mouse’ wheel: (a) ‘mouse’ wheel with attached magnet (b) ‘mouse’ wheel with tachometer tape over attached magnet

21

### 3.3.1 Design D: Hall-Effect Sensor

Design D was built on a standard RH-32 breadboard reflecting the schematic shown in Fig.3.4. First, the A3213EUA-T hall-effect sensor [21] was placed at the edge of the breadboard. Since A3213EUA-T is an open-drain digital sensor, a 10 kΩ pull-up resistor is connected from pin 1 (VDD) to pin 3 (VOUT). Second, the Arduino Nano Every was placed into the breadboard over the central channel, the GND, +5 V Arduino supply and digital pin (D2) were connected to the hall-effect sensor as shown in Fig.3.4. All circuit connections were kept short to maintain signal integrity and reduce the chance of EMI and noise.


Figure 3.4: Schematic diagram of Design D; a Hall-effect sensor with 10 kΩ pull-up resistor

Finally, an Arduino program was developed and uploaded to the Arduino Nano Every (Appendix A.3 Listing A.1). The program utilised an interrupt service routine (ISR) to increment a global counter when a pulse was detected; the condition used was ‘FALLING’. The system recorded the time taken for four consecutive pulses, corresponding to four complete revolutions of the wheel, and subsequently calculated the rotational speed in RPM. The RPM value is then output to the serial interface. This approach allowed for the capturing of precise timestamps on interrupt-triggered events, minimising timing errors associated with polling, and by averaging the RPM calculation over four complete revolutions, the calculated output was a steadier more reliable RPM value.

22

Testing

The steps for Testing Design D are as follows:

1. The motor terminals [25] for the modified ‘mouse’ wheel were connected to the 6 V DC range terminals of a KeySight E3631A variable power supply.
2. The mouse chassis was then placed with the wheel facing the breadboard, magnet and tachometer tape towards the hall-effect sensor. The chassis was then moved till the distance between the sensor and wheel was ≈ 1 mm.
3. The power supply was then turned on and set to a value of 2 V, and it was then noted if the hall-effect sensor was behaving as expected and tripping the interrupt correctly. The distance was then increased until the sensor stopped working; this distance was measured with a set of digital vernier callipers. Repeated three times to find an average.
4. The distance between the sensor and the wheel was reduced back to ≈ 3 mm (Photo of setup), the motor voltage was then set to 1.0 V. The RPM was measured thrice with an AT-6 tachometer, and three concurrent RPM calculated values from the Arduino Serial Monitor. The RPM values were recorded in Excel for later analysis. The voltage was then increased in increments of 1.0 V and measurements retaken till the motor voltage reached 6.0 V.
5. The Keysight DSO1014A oscilloscope was connected to Design D, making sure the oscilloscope probe ratio matched the input signal ratio and the probe point was as close as possible to the hall-effect sensor. Channel 1 was connected to the sensor output ‘VOUT’, and the probe reference was connected to GND.
6. The distance between the sensor and the wheel was set back at ≈ 3 mm, and motor voltage was set to 3.0 V. The steady-state waveform was observed and stored on an external USB as a CSV for later analysis in Excel.

All measurements were taken after a 5-second stabilisation period to minimise transient effects and were conducted at room temperature (approximately 22°C). The oscilloscope output was imported into Excel and used to generate graphs for analysing rise and fall time. The tachometer and Arduino RPM readings were tabulated and averaged, statistical analysis was conducted to review the absolute error.

23

### 3.3.2 Design E: Optical Feedback


Figure 3.5: Schematic diagram of Design E; a Optical sensor module direct connections to Arduino Nano Every.

Design E utilised a TCRT5000 optical sensing module [22], made by Switch Electronics. Using breadboard jumper cables, the module was directly connected to the Arduino Nano Every as per the schematic Fig.3.5. The RPM code (Appendix A.3 Listing A.1) was re-uploaded to the Arduino Nano Every with the ISR updated to look for the ‘RISING’ condition.

Testing

The testing method for Design D followed the same procedure as outlined in Section 3.3.1, except for the sensor being placed ≈ 5 mm away during testing when distances are stated. All measurements were taken under the same conditions and analysed accordingly.

24

## 3.4 Results

### 3.4.1 Design D: Hall-Effect Sensor

The average maximum distance observed before failure was ≈ 3 mm (Appendix A.5 Table A.5).
As summarised in Table 3.1 the hall-effect sensor Arduino RPM values are consistent with the tachometer reference values, with deviation remaining within ±0.54%. This variation in values is due to the integer nature of the Arduino RPM calculation, reducing potential accuracy.

Table 3.1: Hall-effect sensor Arduino Calculated RPM compared to measured Tachometer RPM at varying voltages from 1.0 → 6.0 V (Appendix A.5 Table A.4). The tachometer took readings at an accuracy of 4 s.f. and the Arduino calculated RPM values were set to be integers.

| RPM
Voltage (V) | Tachometer Average | Arduino Average | Absolute Error | Percentage Error
1.0 | 131.3 | 132 | -0.7 | 0.54
2.0 | 350.3 | 350 | 0.3 | 0.10
3.0 | 566.0 | 566 | 0.0 | 0.00
4.0 | 759.3 | 759 | 0.2 | 0.03
5.0 | 982.9 | 983 | -0.1 | 0.01
6.0 | 1176 | 1175 | 0.0 | 0.00

Observing and analysing the output waveforms from the A3213EUA-T on the DSO1014A oscilloscope (Fig.3.6) when triggered, the fall time of the signal to a steady state is ≈ 0.04 µs and the signal has a rise time of ≈ 2.25 µs to steady state. The signal has a clean edge with no oscillation, indicating a strong digital signal.

Cost of Implementation

Table 3.2: Alphabetically Ordered Estimated Component Costs for Design D

Component | Quantity | Unit Price (£) | Total Price (£)
10kΩ Through-Hole Resistor [26] | 1 | 0.07 | 0.07
Allegro A1101EUA-T Hall-Effect Sensor IC [21] | 1 | 0.69 | 0.69
Neodymium Magnet 10mm x 3mm [23] | 1 | 0.11 | 0.11
Total Estimated Cost | | | £0.87

Table 3.2 details the individual components required to implement Design E, alongside their quantities, suppliers and unit costs based on UK-sourced pricing at the time of writing.

25

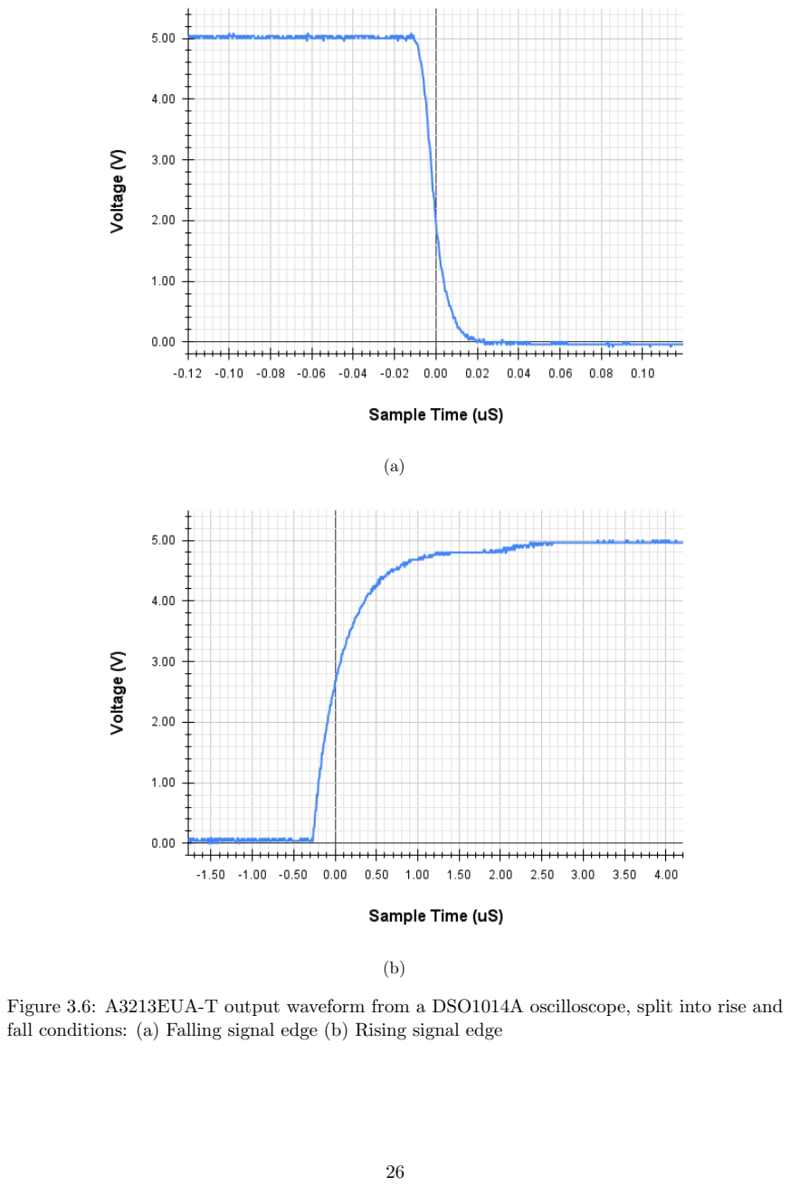
[picture p53: page 32]

(a)

(b)

Figure 3.6: A3213EUA-T output waveform from a DSO1014A oscilloscope, split into rise and fall conditions: (a) Falling signal edge (b) Rising signal edge

26

### 3.4.2 Design E: Optical Feedback

The average maximum distance observed before failure was ≈ 13 mm (Appendix A.5 Table A.7).
As summarised in Table 3.3 the optical sensor Arduino RPM values are consistent with the tachometer reference values, with deviation remaining within ±0.75%. This variation in values is due to the integer nature of the Arduino RPM calculation, reducing potential accuracy.

Table 3.3: Optical sensor Arduino calculated RPM compared to measured Tachometer RPM at varying voltages from 1.0 → 6.0 mm (Appendix A.5 Table A.6). The tachometer took readings at an accuracy of 4 s.f. and the Arduino calculated RPM values were set to be integers.

| RPM
Voltage (V) | Tachometer Average | Arduino Average | Absolute Error | Percentage Error
1.0 | 128.6 | 129 | -0.4 | 0.29
2.0 | 352.6 | 350 | 2.6 | 0.75
3.0 | 565.1 | 567 | -1.9 | 0.34
4.0 | 760.2 | 760 | 0.2 | 0.03
5.0 | 982.9 | 983 | -0.1 | 0.01
6.0 | 1174 | 1174 | 0.0 | 0.00

Observing and analysing the output waveforms from the TCRT5000 sensor module on the DSO1014A oscilloscope (Fig.3.7) when triggered, the fall time of the signal is ≈ 0.045 µs and the signal has a rise time of ≈ 0.045 µs. The signal has oscillations when changing state, indicating a weaker digital signal.

Cost of Implementation

Table 3.4: Alphabetically Ordered Estimated Component Costs for Design E

Component | Quantity | Unit Price (£) | Total Price (£)
Infrared Line Tracking Sensor Module (TCRT5000) [22] | 1 | 1.37 | 1.37
RS Reflective Tachometer Tape [24] | 1 | 0.87 | 0.87
Total Estimated Cost | | | £2.24

Table 3.4 details the individual components required to implement Design E, alongside their quantities, suppliers and unit costs based on UK-sourced pricing at the time of writing.

27

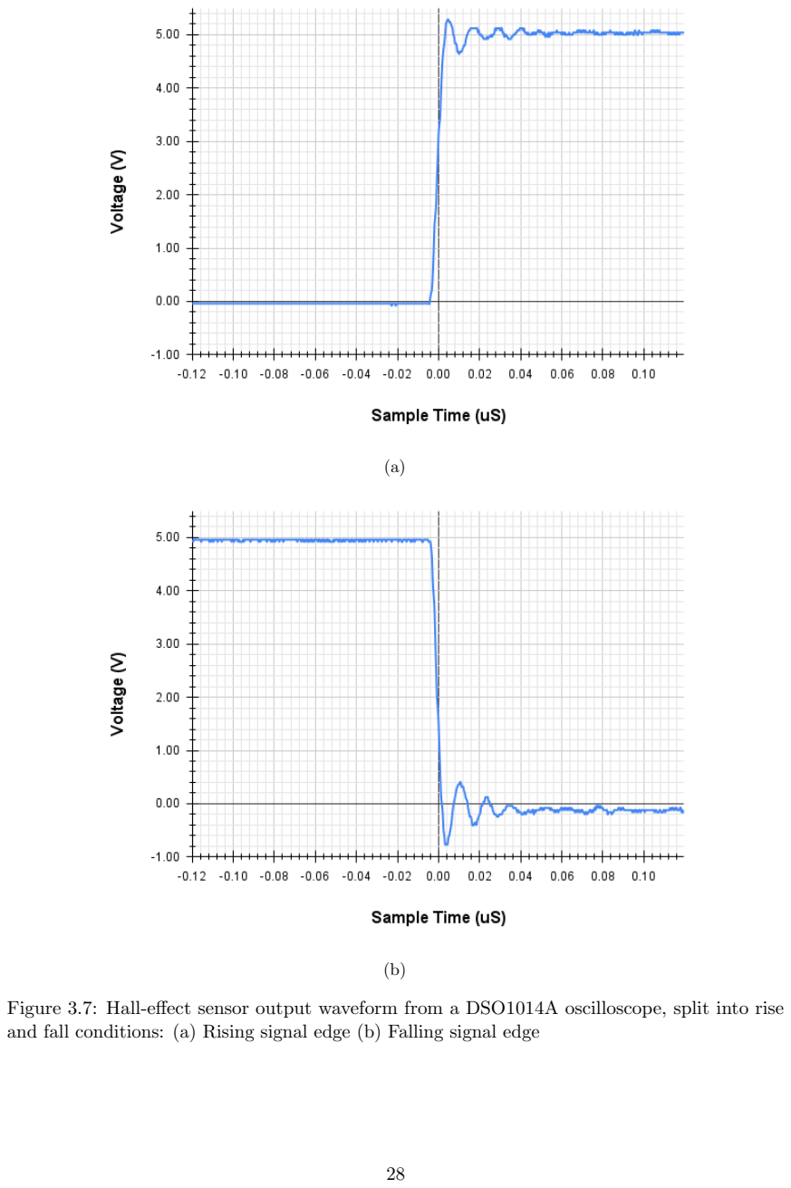
[picture p54: page 34]

(a)

(b)

Figure 3.7: Hall-effect sensor output waveform from a DSO1014A oscilloscope, split into rise and fall conditions: (a) Rising signal edge (b) Falling signal edge

28

## 3.5 Discussion

This section evaluates two design solutions proposed to facilitate the addition of a speed feedback system to improve the control loop currently implemented in the ‘mouse’ design. Both designs worked as expected and provide a reliable RPM value. Design D (HES) may be a more appropriate solution as it provides a potential learning opportunity in magnetic sensing and related components, and not a plug-and-play module.

Design Performance

Design D provided a consistent and reliable RPM. However, the HES and trigger magnet must be within 3mm (Appendix A.4 Figure A.7) of each other to provide accurate detection. Design E provided a stable and accurate RPM. To avoid false positives, the distance between the sensor and reflective tape should be no more than 5mm (Appendix A.4 Figure A.8). In addition, it is recommended that the wheel’s surface be non-reflective.

Complexity

Both Design D and E would be easy to introduce into the ‘mouse’ platform, with various levels of documentation to assist in assembly. However, it is easier to position the HES sensor than the optical module. On the other hand, Design D requires chassis modification in the addition of a magnet to the wheel.

Cost

When comparing the cost of implementation, Design D is the preferable option, only introducing a cost estimate per ‘mouse’ of £0.87, which is £1.37 less than the cost of Design E’s implementation, which is £2.24. However, these costs do not account for the potential technician time to modify the ‘mouse’ chassis.

Further Investigations

Additional research should be conducted on incorporating the RPM measurement into a working ‘mouse’ control loop. In addition, a potential investigation could be conducted on creating an IR optical sensor circuit instead of a pre-fabricated module.

Recommendations

Both Design D and E could be used to great effect on the ‘mouse’ platform. However, I suggest Design D as the most appropriate option, as it provides learning opportunities and reliable, cost-effective RPM measurements.

29

## Current Feedback

## 4.1 Overview

The key focus of this section is the discussion of adding a current feedback sub-system to the autonomous ‘mouse’, addressing the limitation that does not allow for motor current sensing, meaning deteriorating battery health and current spikes during hill ascent cannot be considered when controlling motor speed. The section suggests altering the motor drive sub-system of the ‘mouse’ to add motor current feedback. The motor drive sub-system currently varies the voltage across a 6 V DC motor [25] using a MOSFET or BJT acting as an electronic switch, toggling on and off with a PWM control signal [1]. The proposed solutions must provide reliable, accurate current readings and not adversely affect motor drive control. The solutions will be evaluated based on their stability, simplicity of integration and cost of implementation.

## 4.2 Design Concepts and Methods

Shunt Resistor

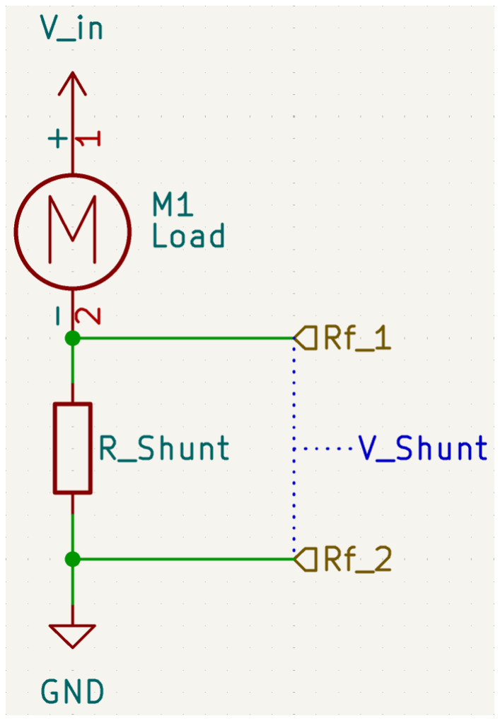
[picture p55: figure]

Figure 4.1: Shunt Resistor Circuit with a motor as circuit load.

Designs F and G utilise a shunt resistor to measure the current within the motor. Generally, a shunt resistor is a precision low-resistance device connected in series with the load (Fig.4.1), ensuring that the load current flows through it and generating a voltage directly related to the magnitude of the current as per Ohm’s Law:

V = IR | (4.1)

The potential difference (voltage drop) is measured across the terminals of the shunt resistor. Rearanging equation 4.1 for I in terms of V and R (Equation 4.2), you can calculate the current from the known resistance and measured voltage.

I =

V R | (4.2)

Shunt resistor values are commonly in the milliohm range to suit different current sensing applications. By choosing a smaller resistance the voltage drop across the shunt resistor will be smaller, and reducing the voltage drop into the millivolt range can minimise power loss and circuit disruption. The small voltage developed is commonly amplified to improve signal accuracy before further processing.

### 4.2.1 Design F: Low-Side Motor Drive

30


Figure 4.2: Low-side N-Channel MOSFET drive circuit controlling a DC Motor Load with transient suppression components.

Design F used a low-side N-channel MOSFET drive circuit (Fig.4.2) to control the operation of a DC motor. The MOSFET acts as an electronic switch in this configuration, enabling or disabling current flow through the motor. When acting like a switch the N-channel MOSFET must have a gate-source voltage (VGS), defined as VGS = VG − VS, sufficiently above the threshold voltage (Vt) potential for reliable conduction [27, p.297]. The gate voltage (VG) is supplied by a control signal applied to the gate terminal (‘Control Signal’), and the source voltage (Vs) is set to GND.
Varying the duty cycle of the control signal modulates the average voltage and current supplied to the motor, providing adjustable speed control. When the signal is high the MOSFET conducts and the inverse is true when the circuit is low. The voltage observed can be calculated using equation 4.3 as described by Rashid [28, p. 920]; where v is the voltage observed, Vs is the supply voltage and δ is the normalised duty cycle (0 → 1.0).
v = δVs | (4.3)

Furthermore, a pull-down resistor (‘R pd’) is utilised within the circuit connecting the gate and source of the transistor; this prevents the gate voltage from floating and pulls it to the same potential (GND) when the signal is low, closing the MOSFET switch.
In addition, as DC motors are inductive loads, switching them introduces transient voltage spikes. The voltage spikes are particularly obvious during turn-off events. To address the voltage spikes and increase stability it is common practice to add:
- A flyback diode is placed directly across the motor terminals [28, pp.970-971], with its cathode connected to the top of the motor. This provides a path for the inductive current from the motor when the MOSFET switches off, safely clamping the voltage spike and protecting the MOSFET from overvoltage conditions.
- A snubber capacitor is placed across the motor terminals [29, p.380] to suppress high-frequency voltage transients and reduce EMI generated by the DC motor.

31

### 4.2.2 Design G: High-Side Motor Drive


Figure 4.3: Schematic of a High-side N-channel MOSFET motor drive circuit with PNP transistor level-shifting stage. Controlling a DC motor with transient suppression components.

Design G used a high-side N-channel MOSFET drive circuit (Fig.4.3) to control the operation of a DC motor. Using a high-side switch allows the load to be directly connected to GND. However, driving an N-channel MOSFET in a high-side position presents a challenge, as the gate-source voltage (VGS) must be raised sufficiently to turn the device on and in a high-side position when conducting the source is connected to the voltage supply (Vs).
A PNP transistor level-shifting stage is employed to overcome this, shifting the input control signal to the Vs level, enabling a low-voltage logic-level control signal to switch the high-side N-channel MOSFET. A PNP transistor works by allowing a current to flow from the emitter to the collector when there is sufficient current observed from the emitter to base (forward-bias) [27, p.246].
The control signal (‘Control Signal’) is applied to the PNP base via a series-connected zener diode (‘ZD2’). Adding a zener diode provides overvoltage protection, ensuring that the PNP transistor’s base-emitter junction remains within its safe operating limits. A pull-up resistor (‘R pu’) is connected between the PNP transistor’s base and the positive supply rail, keeping the transistor turned off when the control signal is floating or at a logic-high level. When the signal transitions low, the base-emitter junction of the PNP transistor becomes forward-biased,

32 turning the transistor on. This action connects the emitter to the collector, allowing the positive supply rail to connect to the N-Channel MOSFET’s gate terminal via a gate resistor (‘R g’). As previously discussed in Section 4.2.1, as the gate voltage rises it exceeds the MOSFET’s source potential (at the same potential as the supply rail ‘Vs during conduction), allowing current to flow from the drain to the source pin and hence through the motor load to GND.
The gate resistor performs two key tasks within this circuit, primarily limiting the current into the gate terminal, which controls the transistor’s switching speed. Additionally, the resistor protects the PNP transistor from transient currents observed during transistor switching events. Typically, gate resistor values are between 1 → 100Ω when used in a motor drive circuit. To further improve system robustness, a zener diode (‘ZD2’) is placed across the MOSFET’s gate and source terminals. The zener clamps the gate voltage (VG) to a safe maximum value, protecting the MOSFET from overvoltage conditions.
The motor load circuit and pull-down resistor (‘R pd’) are included as per the details outlined in Section 4.2.1, the main difference being that the motor load now connects to the MOSFET source pin and GND.
It should be noted that with this design, the PWM response is inverted. When the PWM control signal is low the N-Channel MOSFET is conducting the inverse is true when the signal is high.

## 4.3 Procedures

### 4.3.1 Design F: Low-Side Motor Drive

Assembly


Figure 4.4: Schematic diagram of Design F; a Low-side motor drive circuit with current sensing shunt resistor.

33

Design F was built on a standard RH-32 breadboard following the design outline in Figure
4.4. Firstly, the N-Channel drive circuit was assembled using an IRLZ44N N-Channel MOSFET [30]; the source (pin 3) of the MOSFET was connected to the 1 Ω current sensing shunt resistor in series to GND and the gate (pin 1) is connected to the GND with a 10 kΩ pull-down resistor. The IRLZ44N was choosen for its logic level of 3.3 V (Matches Arduino PWM [31]) and previous use in the ‘mouse’ race as a MOSFET switch.
Secondly, the motor load loop was assembled using a motor from a mouse chassis. First, the motor was connected to the breadboard with single-core wires. Following on, a 1N4001 [32] flyback diode and 100 nF snubbing capacitor were connected over the motor as seen in Figure
4.4. Care was taken in orienting the 1N4001 making sure the anode was connected to the top of the motor. After that the 4.8 V DC 3631A lab power supply rail was connected to the top side of the motor.
Third, the Arduino Nano Every [33] was placed into the breadboard over the central channel. The analogue pin was connected first with A0 connecting to the node between the MOSFET and resistor (Shunt Ref). The D3 pin (Motor PWM) was then connected to the gate of IRLZ44N. Following on, the GND was connected to the Arduino and the 3.3 V DC supply rail from the Arduino was connected to the analogue reference (AREF) pin of the Arduino. By setting the AREF at 3.3 V DC the ADC within the Arduino Nano could measure at increments of ≈ 3.2 mV (LSB) with an accuracy of ±0.5LSB [31].
Finally, an Arduino program was developed and uploaded to the Arduino Nano Every (Appendix A.3 Listing A.2). The program controlled the speed of the DC motor via Pulse Width Modulation (PWM) and monitored the current drawn by the motor. The PWM duty cycle was adjusted within the code to set the motor’s operating speed. The current was measured using one reference point (‘Shunt Ref’) achieved through the analogue input pin A0. The potential difference between the reference point and GND was recorded, and the value was then stored in an array. A moving average algorithm was implemented within the program and calculated based on the array values. The average calculated value was then converted into a current using equation 4.2, as the resistance was 1Ω the value was directly converted from voltage to current. This value was multiplied by a constant of 0.0032 (3.3V /1024 ≈ 0.0032)to convert from the digital signal to an analogue value. This approach allowed for a smoother, more representative current value for each operating condition. The processed current data was then output via the Arduino’s serial interface.

Testing

The steps for Testing Design F are as follows:

1. Design F power supply rails and circuit GND were verified using a KeySight 34450A multimeter.
2. The ‘Motor PWM’ was varied from 0 → 128 incrementing in values of 8, representing a duty cycle range 0 → 50%. The motor voltage and current were measured thrice at each PWM value using a KeySight 34450A multimeter. The voltage values were recorded in Excel and compared to the expected voltages. In addition, the motor current values were recorded in Excel along with the Arduino calculated current values seen on the Serial Monitor.
3. More current readings were then taken from the motor and Arduino whilst applying slight resistance to the wheel, whilst the ‘Motor PWM’ was varied from 0 → 128 incrementing approximating to a 10% change in duty cycle, recording values in Excel.

34

During testing, it was noted that the voltage readings over the motor seemed to be off expectations (Appendix A.5 Table 5). Waveform’s on the oscilloscope suggested the back EMF voltage from the motor seriously impacted readings (Appendix A.5 Figure A.9). A secondary test was completed, replacing the motor load loop with a 1 kΩ resistor connected to the 4.8 V DC 3631A lab power supply rail and pin 2 (Drain) of IRLZ44N. The ‘Motor PWM’ was varied 0 → 128 incrementing in values approximating to a 10% change in duty cycle. The voltage across its terminals was then measured using the KeySight 34450A multimeter, recording values in Excel.
All measurements were taken after a 5-second stabilisation period to minimise transient effects and were conducted at room temperature (approximately 22°C). The multimeter readings were tabulated, and statistical analysis was performed to evaluate the motor’s PWM response and the absolute error for the current readings.

### 4.3.2 Design G: High-Side Motor Drive

Assembly

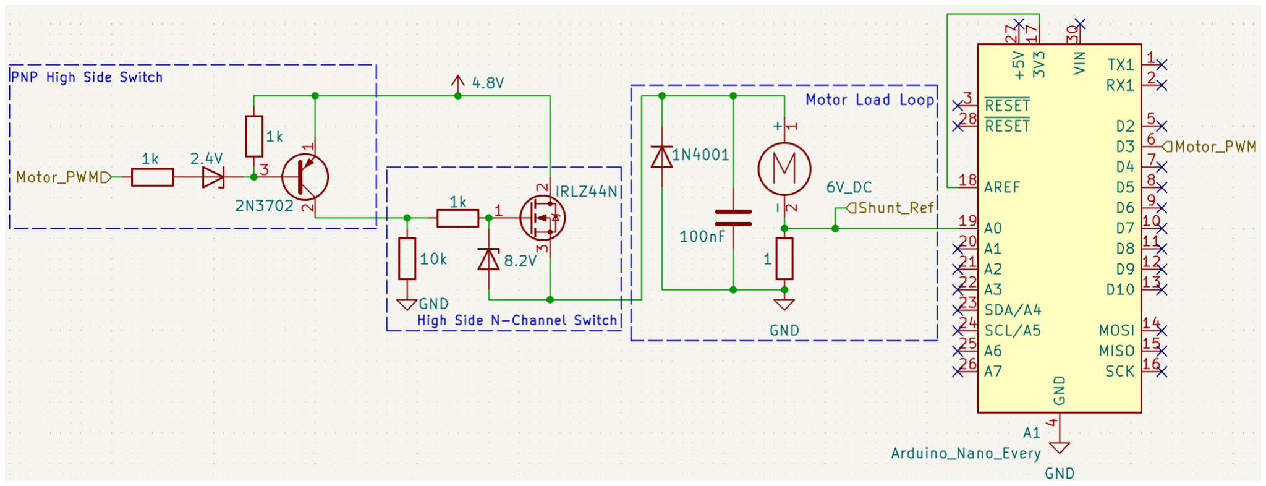
[picture p56: figure]

Figure 4.5: Schematic diagram of Design G; a High-side motor drive circuit with current sensing shunt resistor.

Design F was built on a standard RH-32 breadboard following the schematic in Fig.4.5. Firstly, the PNP high side switch was assembled using a 2N3702 [34]; the emitter (pin 1) of the PNP transitor was connected to the 4.8 V DC supply rail, a 1 kΩ resistor was connected between the base (pin 3) of the transistor and the 4.8 V DC 3631A lab power supply rail. Next, the base clamping 2.4 V zener diode was connected with the cathode connecting to the 2N3702 base (pin 3) and on the anode was connected to a 1 kΩ current limiting resistor.
Secondly, the high-side N-Channel switch was built (Fig.4.5) utilising an IRLZ44N N-Channel MOSFET [30]; the gate (pin 1) was connected with a 1 kΩ gate resitor to the collector of IRLZ44N (pin 2) and the drain (pin 2) was connected to the 4.8 V DC 3631A lab power supply rail. A gate clamping 8.2 V zener diode was connected with the anode connecting to the IRLZ44N source (pin 3) and the cathode directly to the gate. As the schematic shows, a final 10 kΩ pull-down resistor was connected to GND.
Third, the motor loop circuit (Fig.4.5) was assembled as previously described in section 4.3.1, with the following variations:

35

- The current sensing shunt resistor was connected to the bottom of the motor, then to ground.
- The anode of the flyback diode and the capacitor were connected to GND instead of the drain of IRLZ44N.
- The top side of the motor was connected to the source of IRLZ44N and not to the 4.8 V DC supply rail.

Fourth, the Arduino Nano Every was placed into the breadboard over the central channel. The analogue pin was connected first with A0 connecting to the shunt resistor and motor node (‘Shunt Ref’). The D3 pin (Motor PWM) was then connected to the current limiting resistor for the base of 2N3072 as seen in Fig.4.5. Following on, the GND was connected to the Arduino and the +3.3 V DC supply rail from the Arduino was connected to the analogue reference (AREF) pin of the Arduino.
Finally, the Arduino program designed for Design G (Appendix A.3 Listing A.2) was reuploaded to the Arduino Nano Every.

Testing

The testing method for Design F followed the same procedure as outlined in Section 4.3.1 including the secondary investigation, with the exception of varying the PWM from 255 → 128, representing a duty cycle range of 100 → 50%. All measurements were taken under the same conditions and analysed accordingly as defined in 4.3.1.

36

## 4.4 Results

### 4.4.1 Design F: Low-Side Motor Drive

Table 4.1: Design F measured current compared to Arduino current calculated values (Appendix A.5 Table A.8)

| | Current (A)
PWM | Duty Cycle % | Multi-meter Average | Arduino Average | Absolute Error
0 | 0 | 0.001 | 0.00 | -0.001
8 | 3.14 | 0.014 | 0.01 | -0.004
16 | 6.27 | 0.043 | 0.04 | -0.003
24 | 9.41 | 0.080 | 0.08 | 0.000
32 | 12.55 | 0.113 | 0.12 | 0.007
40 | 15.69 | 0.125 | 0.13 | 0.005
48 | 18.82 | 0.163 | 0.16 | -0.003
56 | 21.96 | 0.171 | 0.17 | -0.001
64 | 25.1 | 0.184 | 0.18 | -0.004
72 | 28.24 | 0.188 | 0.19 | 0.002
80 | 31.37 | 0.200 | 0.20 | 0.000
88 | 34.51 | 0.211 | 0.21 | -0.001
96 | 37.65 | 0.221 | 0.22 | -0.001
104 | 40.78 | 0.221 | 0.21 | -0.011
112 | 43.92 | 0.208 | 0.21 | 0.002
120 | 47.06 | 0.214 | 0.22 | 0.006
128 | 50.2 | 0.220 | 0.22 | 0.000

Table 4.2: Design F measured current compared to Arduino current calculated values with pressure applied to wheel (Appendix A.5 Table A.9)

| | Current (A)
PWM | Duty Cycle % | Multi-meter Average | Arduino Average | Absolute Error
24 | 9.41 | 0.085 | 0.09 | 0.005
56 | 21.96 | 0.313 | 0.32 | 0.007
80 | 31.37 | 0.508 | 0.51 | 0.002
104 | 40.78 | 0.710 | 0.71 | 0.000
128 | 50.2 | 0.992 | 0.99 | -0.002

The observed Arduino current values closely followed the multi-meter values (Tables 4.1, 4.2).

37

Table 4.3: Design F measured voltage when the circuit load is a 1 kΩ resistor (Appendix A.5 Table A.10).

| | Voltage (V)
PWM | Duty Cycle % | Expected | Multi-meter Average | Absolute Error
0 | 0 | 0 | 0.000 | 0.000
24 | 9.41 | 0.45 | 0.200 | 0.251
56 | 21.96 | 1.05 | 1.057 | -0.003
80 | 31.37 | 1.51 | 1.500 | 0.006
104 | 40.78 | 1.96 | 1.958 | -0.001
128 | 50.2 | 2.41 | 2.410 | 0.000

In Table 4.3 the discrepancy between expected voltage and measured voltage at 9.4% duty cycle may be caused by incorrect multi-meter averaging of short pulses. However, with the remaining data the measured and expected values closely agree.

Cost of Implementation

Table 4.4: Alphabetically Ordered Estimated Component Costs for Design F

Component | Quantity | Unit Price (£) | Total Price (£)
100nF Polyester Capacitor[35] | 1 | 0.486 | 0.486
10kΩ Resistor [26] | 1 | 0.07 | 0.07
1Ω Resistor [36] | 1 | 0.162 | 0.162
1N4001 Diode [37] | 1 | 0.103 | 0.103
NiMH 1.2V AA Batteries [38] | 4 | 2.243 | 8.972
IRLZ44N N-Channel MOSFET [39] | 1 | 0.717 | 0.717
Total Estimated Cost | | | £10.51

Table 4.4 details the individual components required for the implementation of Design F, alongside their quantities, specifications, suppliers, and unit costs based on UK-sourced pricing at the time of writing. The cost of implementation within the ‘mouse’ would be £12.05, adding a second version of the design without additional NiMH batteries. The cost difference between the original sub-system (Appendix A.2) is +£1.57 an increase in cost of 15%.

38

### 4.4.2 Design G: High-Side Motor Drive

Please note, as mentioned in section 4.2.2, the PWM and duty cycle values are inverted.

Table 4.5: Design G measured current compared to Arduino current calculated values (Appendix A.5 Table A.11)

| | Current (A)
PWM | Duty Cycle % | Multi-meter Average | Arduino Average | Absolute Error
255 | 100 | 0.001 | 0.00 | -0.001
247 | 96.86 | 0.012 | 0.03 | 0.018
239 | 93.73 | 0.026 | 0.04 | 0.014
231 | 90.59 | 0.046 | 0.06 | 0.014
223 | 87.45 | 0.069 | 0.09 | 0.021
215 | 84.31 | 0.096 | 0.13 | 0.034
207 | 81.18 | 0.117 | 0.17 | 0.053
199 | 78.04 | 0.131 | 0.14 | 0.009
191 | 74.9 | 0.145 | 0.18 | 0.035
183 | 71.76 | 0.155 | 0.18 | 0.025
175 | 68.63 | 0.159 | 0.18 | 0.021
167 | 65.49 | 0.168 | 0.20 | 0.032
159 | 62.35 | 0.221 | 0.18 | -0.041
151 | 59.22 | 0.221 | 0.19 | -0.031
143 | 56.08 | 0.208 | 0.21 | 0.002
135 | 52.94 | 0.214 | 0.19 | -0.024
127 | 49.8 | 0.220 | 0.22 | 0.000

Table 4.6: Design G measured current compared to Arduino current calculated values with pressure applied to wheel (Appendix A.5 Table A.12)

| | Current (A)
PWM | Duty Cycle % | Multi-meter Average | Arduino Average | Absolute Error
231 | 90.59 | 0.049 | 0.07 | 0.021
207 | 81.18 | 0.131 | 0.20 | 0.069
183 | 71.76 | 0.238 | 0.29 | 0.052
159 | 62.35 | 0.313 | 0.40 | 0.087
127 | 49.8 | 0.472 | 0.56 | 0.088

The observed Arduino current values are in the same order as the multi-meter values but are not close matches (Tables 4.5, 4.6).

39

Table 4.7: Design G measured voltage when the circuit load is a 1 kΩ resistor (Appendix A.5 Table A.13).

| | Voltage (V)
PWM | Duty Cycle % | Expected | Multi-meter Average | Absolute Error
255 | 100 | 0 | 0.000 | 0.000
231 | 90.59 | 0.45 | 0.194 | 0.257
207 | 81.18 | 0.9 | 0.319 | 0.584
183 | 71.76 | 1.36 | 0.931 | 0.425
159 | 62.35 | 1.81 | 1.151 | 0.656
127 | 49.8 | 2.41 | 1.534 | 0.876

The values seen in Table 4.7 demonstrate a linear relationship between PWM and multi-meter voltage. However, the values measured are significantly lower than expected, particularly at lower duty cycles.

Cost of Implementation

Table 4.8: Alphabetically Ordered Estimated Component Costs for Design G

Component | Quantity | Unit Price (£) | Total Price (£)
100nF Polyester Capacitor[35] | 1 | 0.486 | 0.486
10kΩ Resistor [26] | 1 | 0.07 | 0.07
1kΩ Resistor [8] | 1 | 0.162 | 0.486
1Ω Resistor [36] | 1 | 0.162 | 0.162
1N4001 Diode [37] | 1 | 0.103 | 0.103
2.4V Zener Diode [40] | 1 | 0.129 | 0.129
8.2V Zener Diode [41] | 1 | 0.117 | 0.117
NiMH 1.2V AA Batteries [38] | 4 | 2.243 | 8.972
IRLZ44N N-Channel MOSFET [39] | 1 | 0.717 | 0.717
Total Estimated Cost | | | £11.24

Table 4.8 details the individual components required for the implementation of Design G, alongside their quantities, specifications, suppliers, and unit costs based on UK-sourced pricing at the time of writing. The cost of implementation within the ‘mouse’ would be £13.51, adding a second version of the design without additional NiMH batteries. The cost difference between the original sub-system (Appendix A.2) is +£3.03 an increase in cost of 28%.

## 4.5 Discussion

This section evaluates two design solutions proposed to facilitate the addition of a current feedback system to improve the control loop currently implemented in the ‘mouse’ design. Firstly, of the two designs considered, the low-side design is superior in both performance and cost effectiveness. Secondly, whilst not the focus of this section, the back EMF voltage caused by the motor directly impacts the PWM performance of the motor drive circuit. Directly driving the motor with a PWM drive signal increases undesirable EMI noise due to fast transitions and inductive loads; good layout and screening are recommended.

40

Before further interpreting the findings, it is essential to acknowledge several key limitations. Firstly, no precise method for pressure application was used when testing the current observed in the motor. Conversely, the aim of the current test wasn’t to ascertain the exact pressure to achieve a certain motor current but to investigate the current observation method and its accuracy in relation to varying values. Secondly, for consistency of results the 4.8 V power rail in Design G and F was provided with a laboratory power supply and not batteries, which will have a higher impedance especially as they discharge with use potentially impacting performance. Third, the performance of the designs may have been slightly impacted by the use of the RH-32 breadboard, introducing additional contact impedance.

Design Performance

The motor PWM response in Design F was accurate, and the current sensing addition gave an accurate representation of the current; this fulfils the requirements described in section 4.1. In contrast, Design G was adequate but inferior to Design F in both current sensing and PWM control.

Complexity

Design F is significantly easier to introduce, only requiring minor modification and simple electrical engineering concepts when compared to the current motor drive methods. In contrast, Design G requires extra components and requires high-level understanding of transistor and MOSFET behaviour.

Cost

Comparing the cost of implementation, it is clear that Design F is superior as it only introduces the cost estimate of £2.20 compared to Design Gs cost of £3.03, a difference of £0.81. It should be noted that some of these cost differences when compared to the design seen in [42] have arisen from the different choices in MOSFET or transistor, as well as the choice of motor transient reduction components; therefore, the values seen should be noted as estimates and not accurate representations of true cost per ‘mouse’.

Further Investigations

Further investigation should be conducted on integrating Design F into a working ‘mouse’, developing appropriate software to integrate the motor current measurement into the overall control loop. In addition, a potential investigation of a reduction in the shunt resistor value to ≈ 0.5 Ω could be valuable in terms of extra power potential within the motor, this may involve the introduction of an amplifier or utilising the 1.1 V internal Arduino [31, 33] voltage reference.

Recommendations

Overall, Design F is clearly the most appropriate option when considering the addition of current sensing within the motor, adding reliable data that can be utilised in improvements to ‘mouse’ control loop.

41

## Overall Discussion and Conclusions

Please see the discussion and conclusions of each sub-project named in Table 1.1 (A to G). As previously stated, my recommendations for circuit designs to be included in the ‘mouse’ project going forward are designs B, D and F. In the sub-system sections, specific suggestions have been made regarding future development and project work.
While carrying out the project an additional idea for future project work is to investigate the complete removal of the 9 V alkaline batteries and instead power the entire mouse from 5 x NiMH rechargeable AA batteries. In this configuration, the Arduino would be powered from the AA batteries and supply the voltage required for the operational amplifiers within the position feedback sub-system.
In conclusion, the aims and objectives of this project have been successfully completed.

## Project Review

While the results of the sub-projects are mixed, this has not impacted the overall success of the project with three designs recommended that meet the project objectives defined in section 1.1.1. The designs suggested were reached after various testing methods and are believed to be the most appropriate circuits to facilitate the reduction in batteries and the addition of feedback to the control loop. Observations and testing conducted during the project have deepened the understanding of the mouse limitations and its potential for further investigation and improvement.
I encountered various issues throughout the project, ranging from testing to component malfunction. Each sub-project section discusses the specific testing issues I encountered. However, one recurring issue encountered during testing was the death of 5 Arduino Nanos, a big setback that knocked my confidence and delayed further tests. I was able to fix this problem by rebuilding my circuits on a separate breadboard, suggesting that the issue lay with the breadboard and not my design.
With hindsight, I would focus on one sub-system at a time, as trying to develop three sub-systems in conjunction leads to mistakes being made in circuit prototyping and missing out on further potential improvements. However, this does not override the positives mentioned previously and hence the project should be classed as a success.

## Acknowledgment

## 7.1 Personal Acknowledgment

I wish to thank my supervisor, Dr. Francis Robinson, for guiding me through this project and putting up with my endless questions and queries. Additionally, I would like to thank the lab technicians, Richmond Afeawo and Chun JW Wong, who helped me during testing and integration. I would also like to thank Alasdair Philips, who advised me on various topics during testing and the write-up. Lastly, I would like to acknowledge my partner, Bee, who has helped keep me motivated and has been my rock during this project.

42

## 7.2 AI Acknowledgment

All statements are based of the suggestions seen in [43].
I acknowledge that ChatGPT was used to identify themes in the notes I took from the sources I found. I then grouped and organised these themes into a logical order myself and used or adapted some of the themes’ phrasing in my topic sentences.
I acknowledge that the Pro version of Grammarly was used to correct grammatical and punctuation errors, and to make minor refinements to my draft text. I reviewed the results and take full responsibility for the content of the assignment.

43

## Bibliography

[1] F. V. P. Robinson, “Second-Year Project 3 Mouse Design Briefing Document,” University of Bath, Course Briefing Document EE22005, 2025, pp. 1–11.
[2] N. Johnson, “Review of Speed Control Options for Accurately Controlled Mouse,” University of Bath, BEng Project Scoping and Planning Report, 2025, pp. 1–14.
[3] Texas Instruments, “NE555 Timer Datasheet,” 2017, accessed: 2025-04-29. [Online]. Available: https://www.ti.com/lit/ds/symlink/ne555.pdf
[4] P. Horowitz and W. Hill, The Art of Electronics, 3rd ed. Cambridge University Press, 2015, pp. 638–639.
[5] Texas Instruments, “TL071 Low-Noise JFET-Input Operational Amplifier Datasheet,” 2015, accessed: 2025-04-29. [Online]. Available: https://www.ti.com/lit/ds/symlink/tl071.pdf
[6] Vishay Intertechnology, Inc., “1N4148 High-Speed Switching Diode Datasheet,” 2016, accessed: 2025-04-29. [Online]. Available: https://www.vishay.com/docs/81857/1n4148.pdf
[7] RS Components, “Vishay 100nF Multilayer Ceramic Capacitor MLCC, 50V dc V, ±10% , Through Hole,” 2025, accessed: 2025-04-29. [Online]. Available: https://uk.rs-online.com/web/p/mlccs-multilayer-ceramic-capacitors/8523277?gb=s
[8] ——, “RS PRO 1kΩ Carbon Film Resistor 1W ±5%,” 2025, accessed: 2025-04-29. [Online]. Available: https://uk.rs-online.com/web/p/through-hole-resistors/7078669?gb=s
[9] ——, “Fairchild Switching Diode, 300mA 100V, 2-Pin DO-35 1N4148,” 2025, accessed: 2025-04-29. [Online]. Available: https://uk.rs-online.com/web/p/switching-diodes/8428002?gb=s (https://uk.rs-online.com/web/p/switching-diodes/8428002?gb=s)
[10] ——, “KEMET R82 Polyester Film Capacitor, 63 V ac, 100 V dc, ±5%,
33nF, Through Hole,” 2025, accessed: | 2025-04-29. [Online]. Available: | https:
//uk.rs-online.com/web/p/film-capacitors/3121504?gb=s
[11] ——, “TE Connectivity 51kΩ Metal Film Resistor 0.6W ±1% LR1F51K,” 2025, accessed: 2025-04-29. [Online]. Available: https://uk.rs-online.com/web/p/through-hole-resistors/0148900P?gb=s (https://uk.rs-online.com/web/p/through-hole-resistors/0148900P?gb=s)
[12] ——, “RS PRO Alkaline 9V Battery,” 2025, accessed: 2025-05-04. [Online]. Available: https://uk.rs-online.com/web/p/9v-batteries/8264435?gb=s
[13] ——, “TL071ACP Texas Instruments, Op Amp, 3MHz, 8-Pin PDIP,” 2025, accessed: 2025-04-29. [Online]. Available: https://uk.rs-online.com/web/p/op-amps/0428515?gb=s
[14] ——, | “CHEMI-CON | 1µF | Electrolytic | Capacitor | 50V | dc, | Through | Hole
- | EKY-500ELL1R0ME11D,” | 2025, | accessed: | 2025-04-29. | [Online]. | Available:
https://uk.rs-online.com/web/p/aluminium-capacitors/0374910?gb=s
[15] ——, “RS PRO Single Layer Ceramic Capacitor (SLCC) 2.2nF 2kV dc ±20% Y5U Dielectric, Through Hole +85°C Max Op. Temp.” 2025, accessed: 2025-04-29. [Online]. Available: https://uk.rs-online.com/web/p/single-layer-ceramic-capacitors/1805113?gb=s
[16] ——, “Rubycon 4.7µF Aluminium Electrolytic Capacitor 50V dc, Radial, Through
Hole - 50YXF4.7M5X11,” 2025, accessed: | 2025-04-29. [Online]. Available: | https:
//uk.rs-online.com/web/p/aluminium-capacitors/2244319?gb=s
[17] ——, “RS PRO 47kΩ Carbon Film Resistor 2W ±5%,” 2025, accessed: 2025-04-29. [Online]. Available: https://uk.rs-online.com/web/p/through-hole-resistors/7078930?gb=s

44

[18] ——, “RS PRO 5.6kΩ Carbon Film Resistor 0.25W ±5%,” 2025, accessed: 2025-04-29. [Online]. Available: https://uk.rs-online.com/web/p/through-hole-resistors/7077723?gb=s
[19] ——, “EPCOS B32529 Polyester Film Capacitor, 63 V ac, 100 V dc, ±5%, 10nF, Through Hole,” accessed: 2025-04-29. [Online]. Available: https://uk.rs-online.com/web/p/film-capacitors/0334243?gb=s (https://uk.rs-online.com/web/p/film-capacitors/0334243?gb=s)
[20] ——, “Texas Instruments NE555P, Precision Timer, 8-Pin PDIP,” 2025, accessed: 2025-05-04. [Online]. Available: https://uk.rs-online.com/web/p/timer-circuits/2215535
[21] Allegro MicroSystems, “A3213 and A3214 - Micropower Ultra-Sensitive Hall-Effect Switches,” accessed: 2025-04-28. [Online]. Available: https://www.allegromicro.com/-/media/files/datasheets/a3213-4-datasheet.pdf (https://www.allegromicro.com/-/media/files/datasheets/a3213-4-datasheet.pdf)
[22] Switch Electronics, “Infrared Line Tracking Tracker Follower Sensor Module TCRT5000,” accessed: 2025-04-28. [Online]. Available: https://www.switchelectronics.co.uk/products/infrared-line-tracking-tracker-follower-sensor-module-tcrt5000srsltid=AfmBOooiK0csJWyTVAdvbmhEcUuLzCFnZ6 a3m30Mz1amg-5j6MsRVoR
[23] RS Components, “RS PRO Neodymium Magnet 0.09kg, Width 3mm,” accessed: 2025-04-28. [Online]. Available: https://uk.rs-online.com/web/p/neodymium-magnets/2192257?gb=s
[24] RS Components , “RS PRO Tachometer Reflective Tape,” accessed: 2025-04-28. [Online]. Available: https://uk.rs-online.com/web/p/tachometer-accessories/8459731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 (https://uk.rs-online.com/web/p/tachometer-accessories/8459731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)
[25] MFA, “MFA 918D5001/1 500:1 Gearbox and Motor 1.5-3V,” 2019, accessed: 2025-04-28. [Online]. Available: https://cdn.shopify.com/s/files/1/0695/1347/8453/files/918D.pdf
[26] RS Components, “TE Connectivity 10kΩ Metal Film Resistor 0.6W ±1% LR1F10K,”
2025, accessed: | 2025-05-04. [Online]. Available: | https://uk.rs-online.com/web/p/
through-hole-resistors/1251164 (https://uk.rs-online.com/web/p/through-hole-resistors/1251164)
[27] A. S. Sedra and K. C. Smith, Microelectronic Circuits, 7th ed. Oxford University Press, 2015, pp. 246, 297.
[28] M. H. Rashid, Power Electronics Handbook: Devices, Circuits, and Applications, 4th ed. Elsevier, 2018, pp. 920, 970–971.
[29] T. Williams, EMC for Product Designers, 4th ed. Newnes, 2007, p. 380.
[30] Infineon Technologies AG, “IRLZ44N DataSheet,” 2016, accessed: 2025-04-29. [Online]. Available: https://www.infineon.com/dgdl/Infineon-IRLZ44N-DataSheet-v01 01-EN.pdf? fileId=5546d462533600a40153567217c32725 (https://www.infineon.com/dgdl/Infineon-IRLZ44N-DataSheet-v01_01-EN.pdf?fileId=5546d462533600a40153567217c32725)
[31] Microchip Technology Inc., “ATmega4808/4809 8-bit AVR Microcontroller Datasheet,” 2018, accessed: 2025-04-29. [Online]. Available: https://ww1.microchip.com/downloads/en/DeviceDoc/ATmega4808-4809-Data-Sheet-DS40002173A.pdf (https://ww1.microchip.com/downloads/en/DeviceDoc/ATmega4808-4809-Data-Sheet-DS40002173A.pdf)
[32] Kitronik Ltd., “1N4001 Diode Datasheet,” 2018, accessed: 2025-04-29. [Online]. Available: https://resources.kitronik.co.uk/pdf/1N4001.pdf
[33] Arduino AG, “Arduino Nano Every (ABX00028) Datasheet,” 2019, accessed: 2025-04-29. [Online]. Available: https://docs.arduino.cc/resources/datasheets/ABX00028-datasheet.pdf
[34] Components101, “2N3702 PNP Transistor Datasheet,” 2019, accessed: 2025-04-29. [Online]. Available: https://components101.com/sites/default/files/component datasheet/ 2N3702-Datasheet.pdf (https://components101.com/sites/default/files/component_datasheet/2N3702-Datasheet.pdf)
[35] RS Components, “WIMA MKS2 Polyester Film Capacitor, 63 V ac, 100 V dc, ±10%, 100nF, Through Hole,” accessed: 2025-04-29. [Online]. Available: https://uk.rs-online.com/web/p/film-capacitors/1082700

45

[36] ——, “RS PRO 1Ω Carbon Film Resistor 1W ±5%,” accessed: 2025-04-29. [Online]. Available: https://uk.rs-online.com/web/p/through-hole-resistors/7078546?gb=s
[37] ——, “Vishay 50V 1A, Rectifier Diode, 2-Pin DO-204AL 1N4001-E3/54,” accessed: 2025-04-29. [Online]. Available: https://uk.rs-online.com/web/p/schottky-diodes-rectifiers/6288931?gb=s (https://uk.rs-online.com/web/p/schottky-diodes-rectifiers/6288931?gb=s)
[38] ——, “RS PRO NiMH Rechargeable AAA Battery, 800mAh, 1.2V,” accessed: 2025-04-29. [Online]. Available: https://uk.rs-online.com/web/p/aaa-rechargeable-batteries/5046051?gb=s (https://uk.rs-online.com/web/p/aaa-rechargeable-batteries/5046051?gb=s)
[39] ——, “Infineon HEXFET N-Channel MOSFET, 47 A, 55 V, 3-Pin TO-220AB IRLZ44NPBF,” accessed: 2025-04-29. [Online]. Available: https://uk.rs-online.com/web/p/mosfets/9194814?gb=s (https://uk.rs-online.com/web/p/mosfets/9194814?gb=s)
[40] ——, “Nexperia, 2.4V Zener Diode 5% 500 mW Through Hole 2-Pin DO-35,” accessed: 2025-04-29. [Online]. Available: https://uk.rs-online.com/web/p/zener-diodes/5443503?gb=s (https://uk.rs-online.com/web/p/zener-diodes/5443503?gb=s)
[41] ——, “Nexperia, 8.2V Zener Diode 5% 500 mW Through Hole 2-Pin DO-355,” accessed: 2025-04-29. [Online]. Available: https://uk.rs-online.com/web/p/zener-diodes/5444449?gb=s (https://uk.rs-online.com/web/p/zener-diodes/5444449?gb=s)
[42] N. Johnson, “Mouse Final Report,” University of Bath, Coursework Submission, 2023, pp. 1–17.
[43] D. R. Rowland, “Two frameworks to guide discussions around levels of acceptable use of generative ai in student academic research and writing,” Journal of Academic Language and Learning, vol. 17, no. 1, pp. T31–T69, Aug. 2023. [Online]. Available: https://journal.aall.org.au/index.php/jall/article/view/915

46

## Appendices

## A.1 Project Costs

Table A.1: Total Project Costs

Item | Quantity | Cost | Total Cost
100nF Ceramic Disc Capacitor (50V) | 7 | £0.17 | £1.19
100nF Polyester Capacitor | 2 | £0.49 | £0.97
10kΩ Through-Hole Resistor | 3 | £0.07 | £0.21
10nF Polyester Capacitor | 1 | £0.11 | £0.11
1kΩ Resistor | 7 | £0.16 | £1.13
1N4001 Diode | 2 | £0.10 | £0.21
1N4148 Signal Diode | 2 | £0.01 | £0.02
1µF Electrolytic Capacitor | 1 | £0.22 | £0.22
1Ω Resistor | 10 | £0.16 | £1.62
2.2nF Ceramic Capacitor | 1 | £0.07 | £0.07
2.4V Zener Diode | 1 | £0.13 | £0.13
33nF Capacitor (Polyester, 100V) | 2 | £0.12 | £0.24
4.7µF Electrolytic Capacitor | 1 | £0.21 | £0.21
47kΩ Resistor | 1 | £0.17 | £0.17
5.6kΩ Resistor | 1 | £0.11 | £0.11
51kΩ Resistor | 2 | £0.05 | £0.11
8.2V Zener Diode | 1 | £0.12 | £0.12
9V Battery (RS PRO Alkaline) | 1 | £2.08 | £2.08
Allegro Microsystems Through Hole Hall Effect Sensor | 5 | £0.61 | £3.05
Arduino Nano Every | 9 | £11.55 | £103.95
IRLZ44N N-Channel MOSFET | 4 | £0.72 | £2.87
NE555P Timer IC | 1 | £0.15 | £0.15
NiMH 1.2V AA Batteries | 4 | £2.24 | £8.97
RS PRO Neodymium Magnet 0.09kg, Width 3mm. | 1 | £4.69 | £4.69
RS PRO Tachometer Reflective Tape. | 1 | £8.24 | £8.24
Single Core Wire (Various Lengths) | 1 | £15.00 | £15.00
TCRT5000 Module Switch Electronics | 4 | £1.37 | £5.48
TL071 Op-Amp (Single BiFET) | 2 | £0.45 | £0.90
Total Project Cost | | | £162.21

Table A.1 details the total project costs; items such as battery cradles and breadboard jumper wires have not been included due to them being borrowed and returned to EEE stores. I estimate the time contribution from Lab Technicians to be 2 hours.

47

## A.2 Original Sub-System Estimated Cost

Table A.2: Estimated cost of position feedback sub-system without LC filter, adapted from the circuit and cost appendix seen in [42].

Component | Quantity | Unit Price (£) | Total Price (£)
33nF Capacitor | 2 | 0.12 | 0.24
100nF Capacitor | 2 | 0.17 | 0.34
TL071 OpAmp | 2 | 0.45 | 0.90
1N4148 Signal Diode | 4 | 0.01 | 0.04
4.7kΩ Resistor | 2 | 0.02 | 0.04
470kΩ Potentiometer | 2 | 0.85 | 1.70
9V Batteries | 2 | 2.08 | 4.16
Total Estimated Cost | | | £7.38

Table A.3: Estimated cost of motor drive sub-system, adapted from the circuit and cost appendix seen in [42].

Component | Quantity | Unit Price (£) | Total Price (£)
100nF Capacitor | 2 | 0.486 | 0.972
1N4148 Signal Diode | 2 | 0.01 | 0.02
TIP120 | 2 | 0.26 | 0.52
NiMH 1.2V AA Batteries | 4 | 2.243 | 8.972
Total Estimated Cost | | | £10.48

48

## A.3 Arduino Program Code

Listing A.1: RPM Calculation utilising interupts on the Arduino Nano Every

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

void se t up ( ) {
S e r i a l . b e gi n ( 9 6 0 0 ) ;

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

Listing A.2: Current Calulation using One Refernce point Arduino Nano Every // V ol a t g e Re fe rence
const int VoltREF = 3 . 3 ;

//Pin Ass ignmen t
const int MTR = 3 ;

49

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

void se t up ( ) {
S e r i a l . b e gi n ( 9 6 0 0 ) ;
pinMode (MTR, OUTPUT) ;
a n al o gR e f e r e n c e (EXTERNAL) ;

for ( int t hi sR e a di n g = 0 ; t hi sR e a di n g < numReadings ; t hi sR e a di n g++) r e a di n g s [ t hi sR e a di n g ]= 0 ;
}

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

// S e i a l Se tup
S e r i a l . p ri n t ( ” 0 , ” ) ; S e r i a l . p r i n t ( ” 1 , ” ) ;

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

50

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

S e r i a l . p r i n t l n ( c u r r e n t ) ;
}

## A.4 Equipment and Testing


Figure A.1: RH-32 Breadboard

51

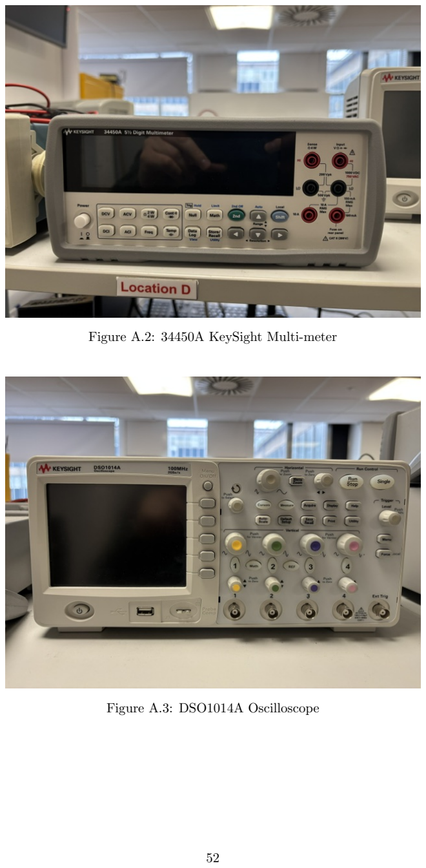
[picture p57: page 58]

Figure A.2: 34450A KeySight Multi-meter

Figure A.3: DSO1014A Oscilloscope

52

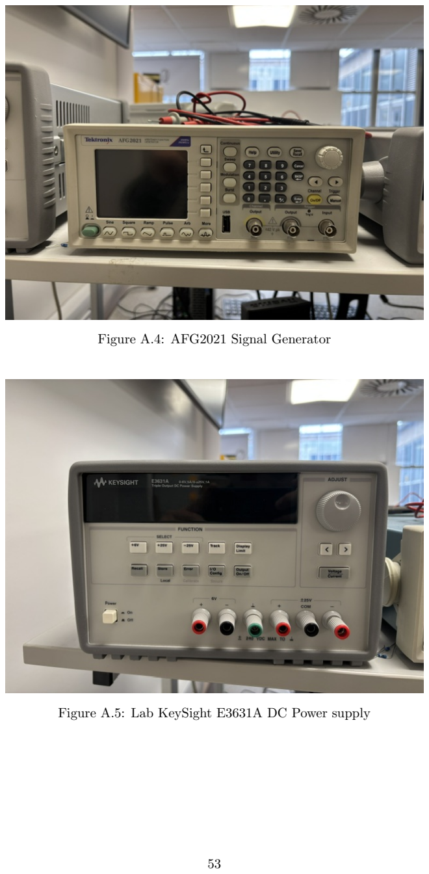
[picture p58: page 59]

Figure A.4: AFG2021 Signal Generator

Figure A.5: Lab KeySight E3631A DC Power supply

53

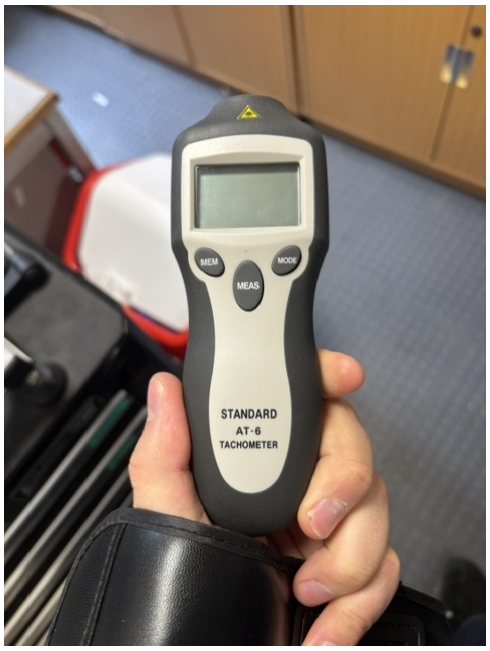
[picture p59: figure]

Figure A.6: AT-6 Tachometer

54

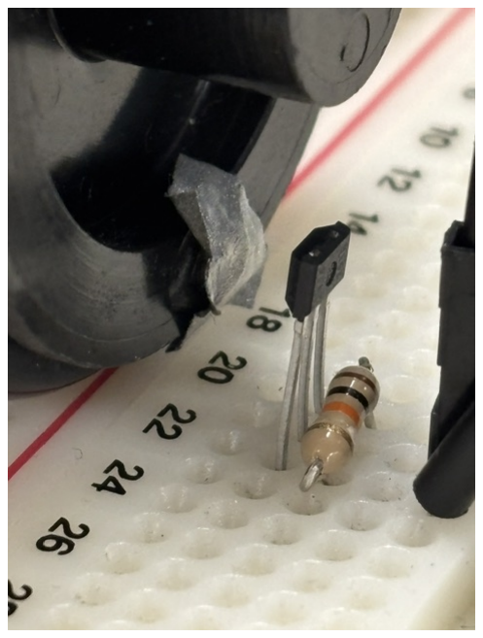
[picture p60: figure]
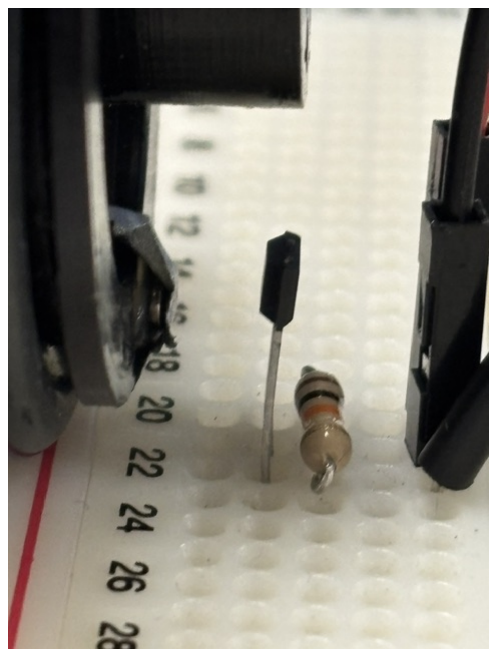
[picture p61: figure]

(a) HES Distance Angle 1 | (b) HES Distance Angle 2

Figure A.7: Hall-Effect Sensor Distance at Different Angles

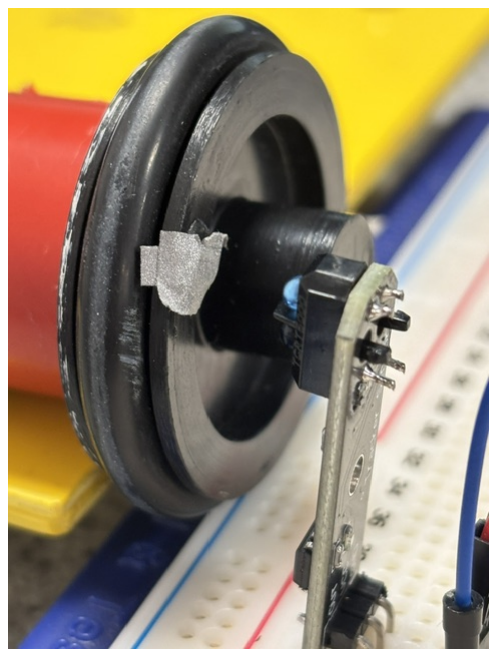
[picture p62: figure]
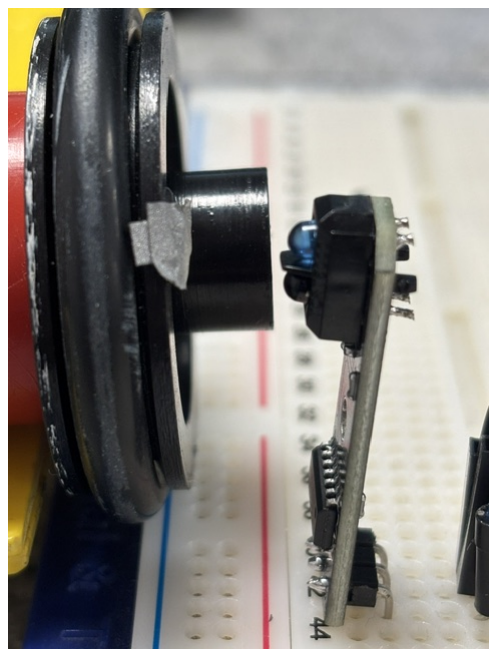
[picture p63: figure]

(a) Optical Distance Angle 1 | (b) Optical Distance Angle 2

Figure A.8: Optical Sensor Distance at Different Angles

## A.5 Data

55

# A.4 : Hall-Effect Sensor RPM Measurements compared to Tachometer Readings

Voltage | Tachometer Readings (RPM) | Arduino Calculated Value (RPM) | Absolute Error | Percentage Error
1 | 2 | 3 | Average | 1 | 2 | 3 | Average
1 | 131.2 | 131.4 | 131.3 | 131.3 | 132 | 132 | 131 | 132 | -0.7 | 0.54
2 | 350.2 | 350.4 | 350.5 | 350.3 | 350 | 351 | 350 | 350 | 0.3 | 0.10
3 | 565.9 | 565.9 | 566.1 | 566.0 | 566 | 566 | 566 | 566 | 0.0 | 0.00
4 | 759.1 | 759.2 | 759.3 | 759.2 | 759 | 760 | 759 | 759 | 0.2 | 0.03
5 | 982.8 | 983.0 | 982.9 | 982.9 | 983 | 983 | 983 | 983 | -0.1 | 0.01
6 | 1175 | 1175 | 1175 | 1175 | 1175 | 1175 | 1175 | 1175 | 0.0 | 0.00

# A.5 : Hall-Effect Sensor Working Distance (mm)

1 | 2 | 3 | Average
3.06 | 3.00 | 3.05 | 3.04

# A.6 : IR Optical Sensor RPM Measurements compared to Tachometer Readings

Voltage | Tachometer Readings (RPM) | Arduino Calculated Value (RPM) | Absolute Error | Percentage Error
1 | 2 | 3 | Average | 1 | 2 | 3 | Average
1 | 128.5 | 128.6 | 128.8 | 128.6 | 129 | 128 | 130 | 129 | -0.4 | 0.29
2 | 352.5 | 352.7 | 352.7 | 352.6 | 350 | 351 | 350 | 350 | 2.6 | 0.75
3 | 565 | 565.1 | 565.2 | 565.1 | 566 | 567 | 567 | 567 | -1.9 | 0.34
4 | 760.1 | 760.4 | 760.2 | 760.2 | 760 | 760 | 760 | 760 | 0.2 | 0.03
5 | 982.8 | 982.8 | 983.0 | 982.9 | 983 | 984 | 983 | 983 | -0.1 | 0.01
6 | 1174 | 1174 | 1174 | 1174 | 1174 | 1174 | 1174 | 1174 | 0.0 | 0.00

# Table A.7 : Optical Sensor Working Distance (mm)

1 | 2 | 3 | Average
12.95 | 12.98 | 13.01 | 12.98


Figure A.9: Oscilloscope response over the motor at 50% duty cycle, demonstrating the issues encountered with back EMF from the motor.

57

## Table A.8 : Low Side Motor Drive Ciruit Voltage and Current Measurements

PWM | Duty Cycle (%) | Expected Voltage (V) | Voltage Observed (V) | Absolute Error | Current (Multi-meter) (A) | Current Arduino (A) | Absolute Error
1 | 2 | 3 | Average | | 1 | 2 | 3 | Average | 1 | 2 | 3 | Average
0 | 0 | 0 | 0.000 | 0.000 | 0.000 | 0.000 | 0.000 | 0.001 | 0.001 | 0.001 | 0.001 | 0.00 | 0.00 | 0.00 | 0.00 | -0.001
8 | 3.14 | 0.15 | 0.000 | 0.000 | 0.000 | 0.000 | -0.150 | 0.014 | 0.013 | 0.014 | 0.014 | 0.01 | 0.01 | 0.01 | 0.01 | -0.004
16 | 6.27 | 0.3 | 0.000 | 0.000 | 0.000 | 0.000 | -0.300 | 0.043 | 0.043 | 0.044 | 0.043 | 0.04 | 0.05 | 0.04 | 0.04 | -0.003
24 | 9.41 | 0.45 | 0.093 | 0.094 | 0.094 | 0.094 | -0.356 | 0.081 | 0.079 | 0.080 | 0.080 | 0.07 | 0.08 | 0.08 | 0.08 | 0.000
32 | 12.55 | 0.6 | 0.803 | 0.805 | 0.804 | 0.804 | 0.204 | 0.114 | 0.112 | 0.112 | 0.113 | 0.12 | 0.13 | 0.10 | 0.12 | 0.007
40 | 15.69 | 0.75 | 1.141 | 1.142 | 1.143 | 1.142 | 0.392 | 0.123 | 0.125 | 0.127 | 0.125 | 0.13 | 0.12 | 0.14 | 0.13 | 0.005
48 | 18.82 | 0.9 | 1.914 | 1.916 | 1.915 | 1.915 | 1.015 | 0.163 | 0.163 | 0.164 | 0.163 | 0.16 | 0.16 | 0.17 | 0.16 | -0.003
56 | 21.96 | 1.05 | 2.228 | 2.228 | 2.229 | 2.228 | 1.178 | 0.170 | 0.172 | 0.171 | 0.171 | 0.17 | 0.16 | 0.17 | 0.17 | -0.001
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
231 | 90.59 | 0.45 | 0.193 | 0.195 | 0.194 | 0.194 | 0.257
207 | 81.18 | 0.9 | 0.319 | 0.320 | 0.319 | 0.319 | 0.584
183 | 71.76 | 1.36 | 0.930 | 0.931 | 0.930 | 0.931 | 0.425
159 | 62.35 | 1.81 | 1.151 | 1.151 | 1.152 | 1.151 | 0.656
127 | 49.8 | 2.41 | 1.533 | 1.534 | 1.535 | 1.534 | 0.876
