n0aheuw/Individual-Project---Mouse-Investigation/Report_LATEX/circuits/shunt_amp.png

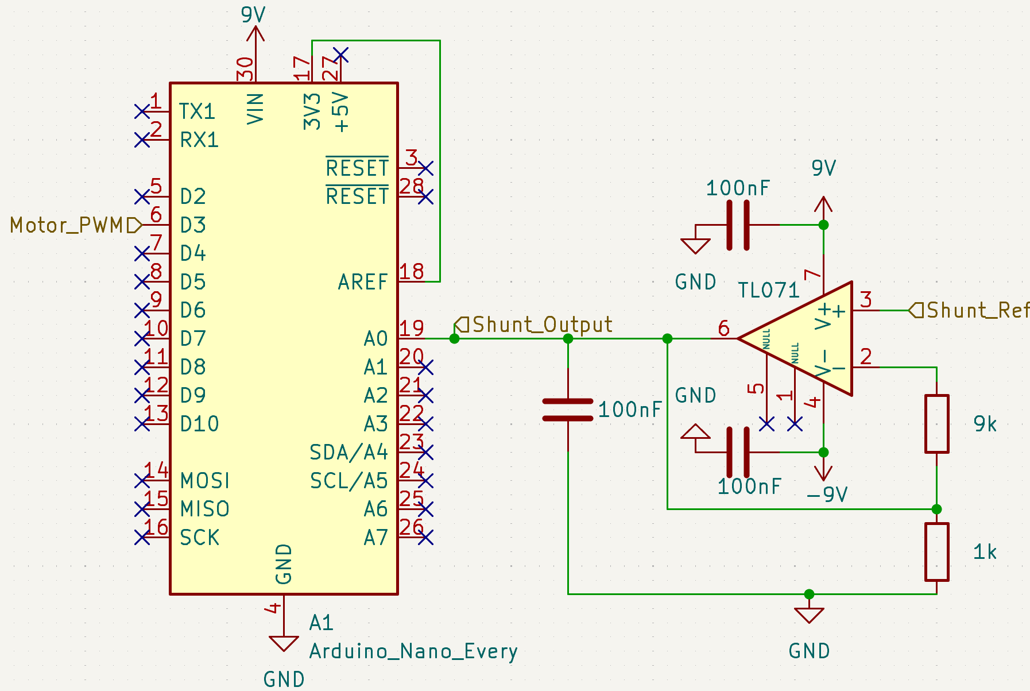
Report_LATEX/circuits/shunt_amp.png
