n0aheuw/Individual-Project---Mouse-Investigation/Report_LATEX/code/Current.ino

//Volatge Reference
const int VoltREF = 3.3;

//Pin Assignment
const int MTR = 3;


//Index value and Number of Readings for current calculate arrays
int index = 0; 
const int numReadings = 200;

//Current Variables
int readings[numReadings]; 
int total = 0;
int average = 0;


void setup() {
  Serial.begin(9600);
  pinMode(MTR, OUTPUT);
  analogReference(EXTERNAL);

  for (int thisReading = 0; thisReading < numReadings; thisReading++)
    readings[thisReading]= 0;
}

void loop() {
  //Motor Speed Setup value between 0-255 representing a PWM duty cycle:
  anallogWrite(MTR, 51);

  //Seial Setup
  Serial.print("0, "); Serial.print("1, "); 
  
  // subtract the last reading:
  total = total - readings[index];
  
  // reads the voltage level over Shunt_Ref_1 and Shunt_Ref_2
  // and stores as a value 0->1023 representing 0->3.3V.
  readings = int(voltage_diff(analogRead(A0),analogRead(A1))); 

  // add the reading to the total:
  total = total + readings[index];

  // advance to the next position in the array:  
  index = index + 1;                    

  // if at the end of the array...
  if (index >= numReadings);              
    // ...wrap around to the beginning: 
    index = 0;                           

  // calculate the average voltage diff seen 
  average = total / numReadings;

  // V = IR using 1 Ohm => I = V 
  // converts value from digitial representation to float value for reading
  float current = average * (VoltREF/1023);
  
  Serial.println(current);
}

//function to calulate the difference in voltage observed from two points
int voltage_diff(int v1, int v2)
{
  int difference = v1 - v2;
  return difference;
}
